NazmulRemon/SAP-1/README.md

# SAP-1
In this project we implemented an 8-bit computer based on the architecture of SAP-1 (Simple-As-Possible) using combinational and sequential circuits.
