NazmulRemon/SAP-1/Instruction Register/bottomcopper_mirrer.PDF

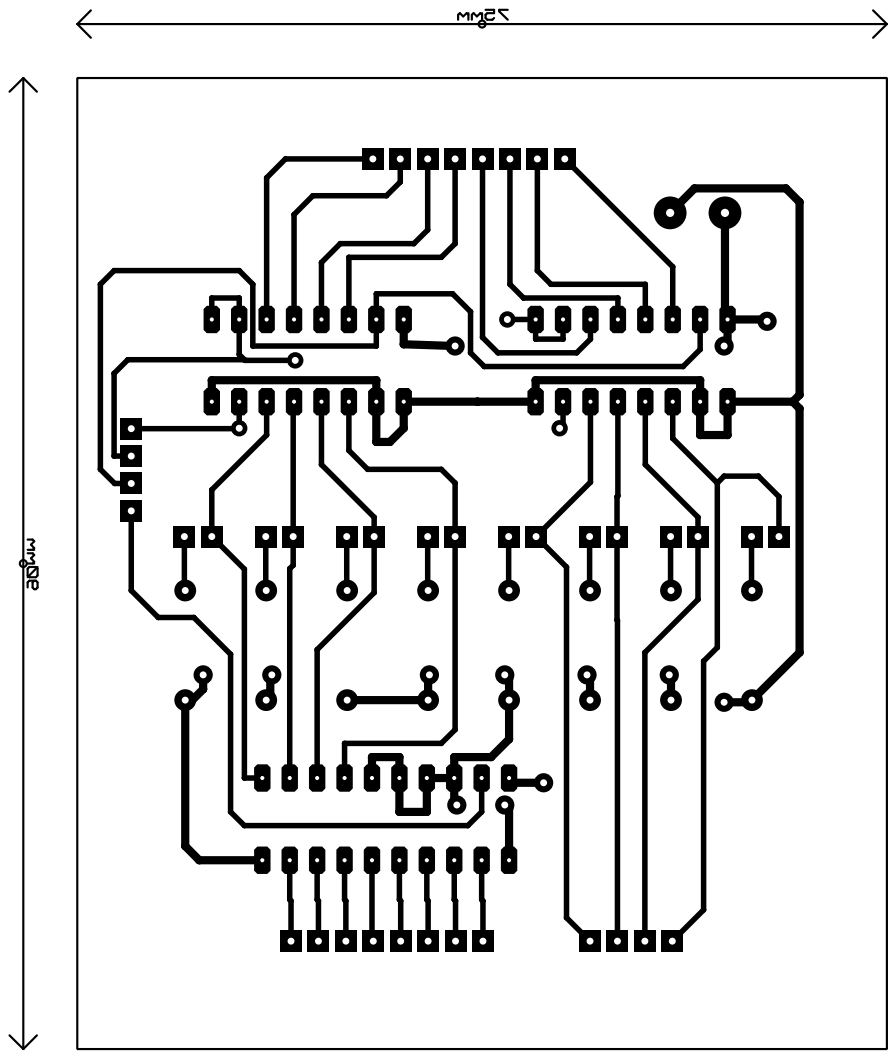
[picture p33: page 1]
