NazmulRemon/SAP-1/Instruction Register/topcopper.PDF

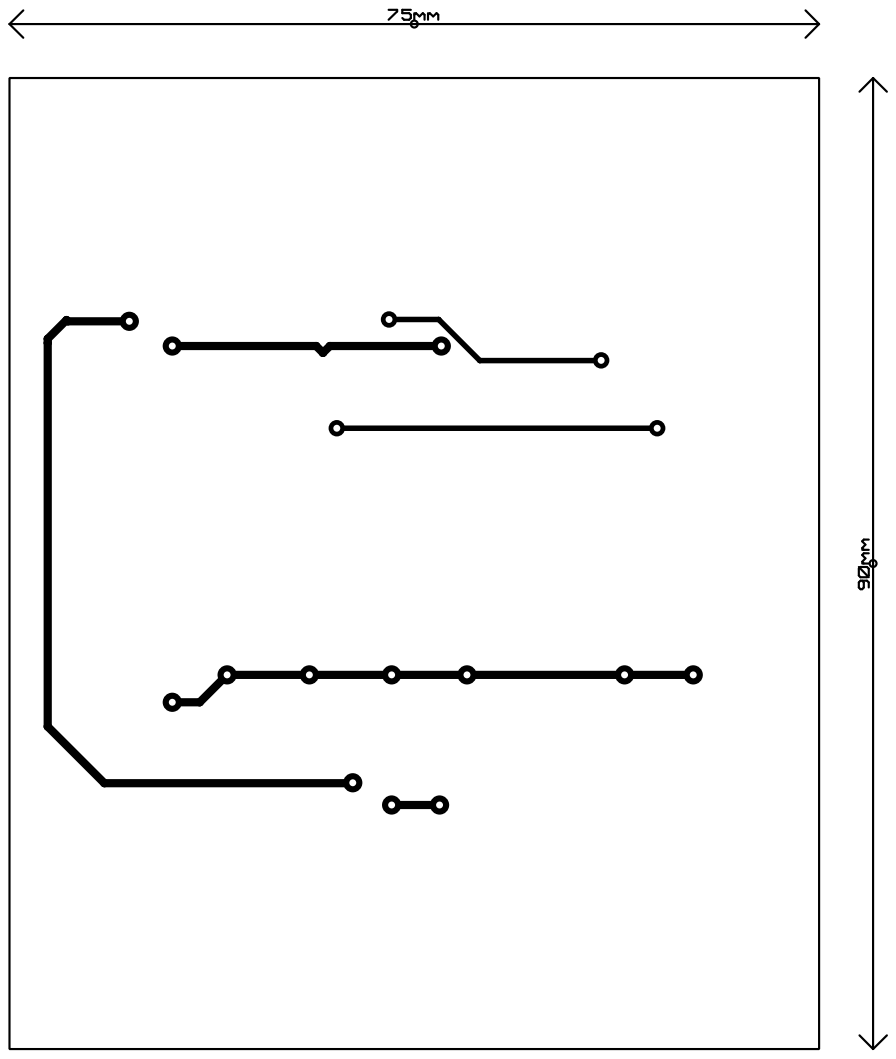
[picture p34: page 1]
