NazmulRemon/SAP-1/Instruction Register/topsilk.PDF

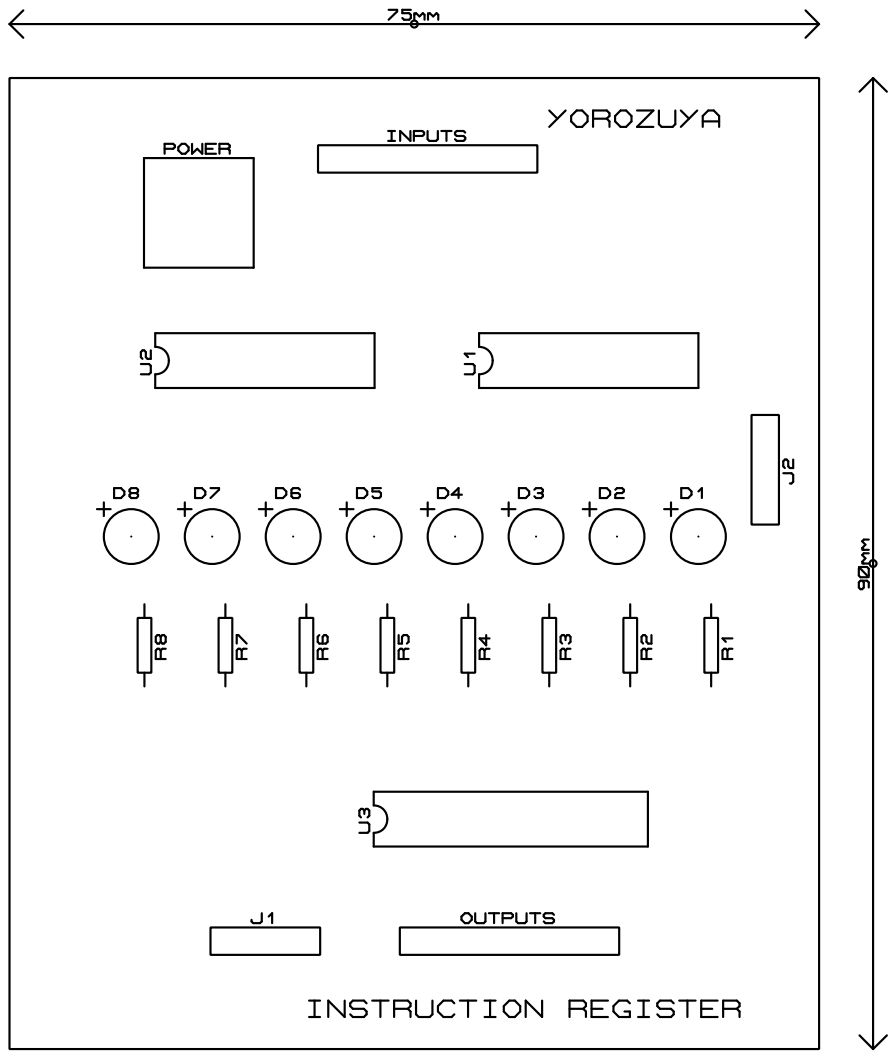
[picture p35: page 1]
