NazmulRemon/SAP-1/RAM/BOTTOMCOPPER_MIRROR.PDF

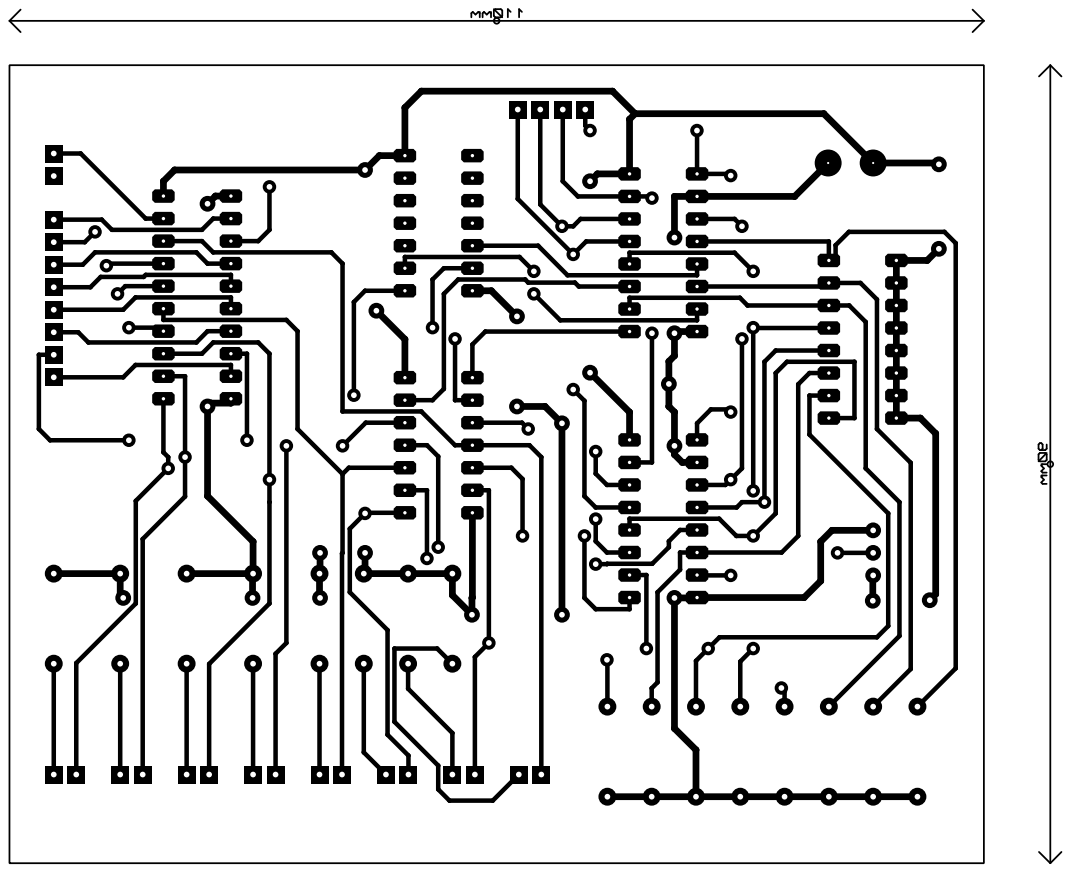
[picture p36: page 1]
