NazmulRemon/SAP-1/RAM/TOPCOPPER.PDF

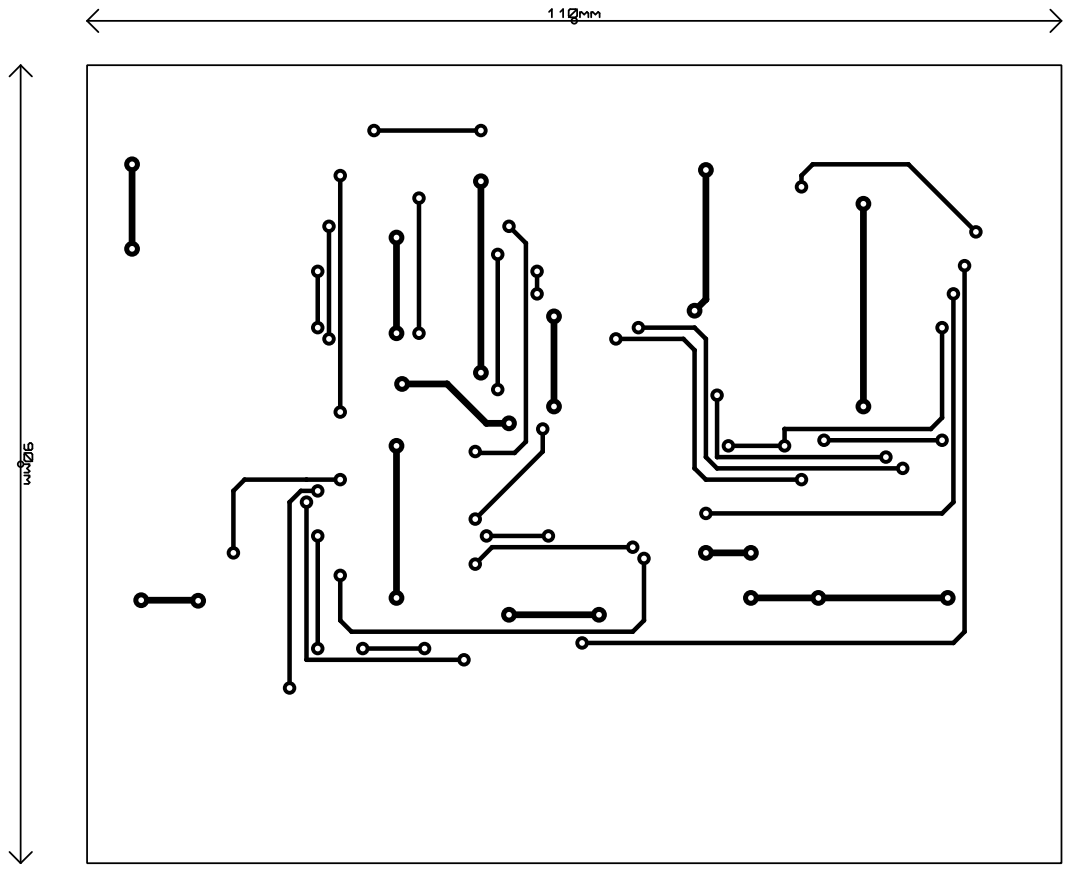
[picture p37: page 1]
