NazmulRemon/SAP-1/RAM/TOPSILK.PDF

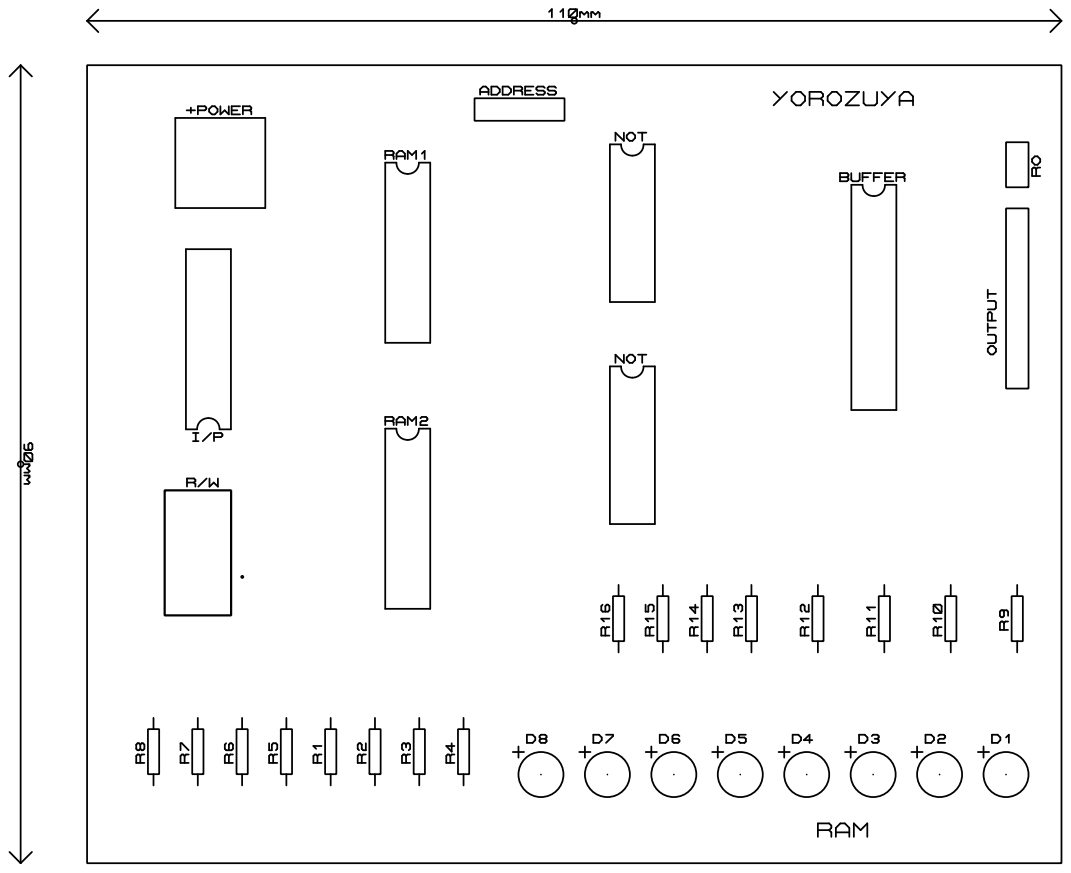
[picture p38: page 1]
