NazmulRemon/SAP-1/Power module/BOTTOMCOPPER.PDF

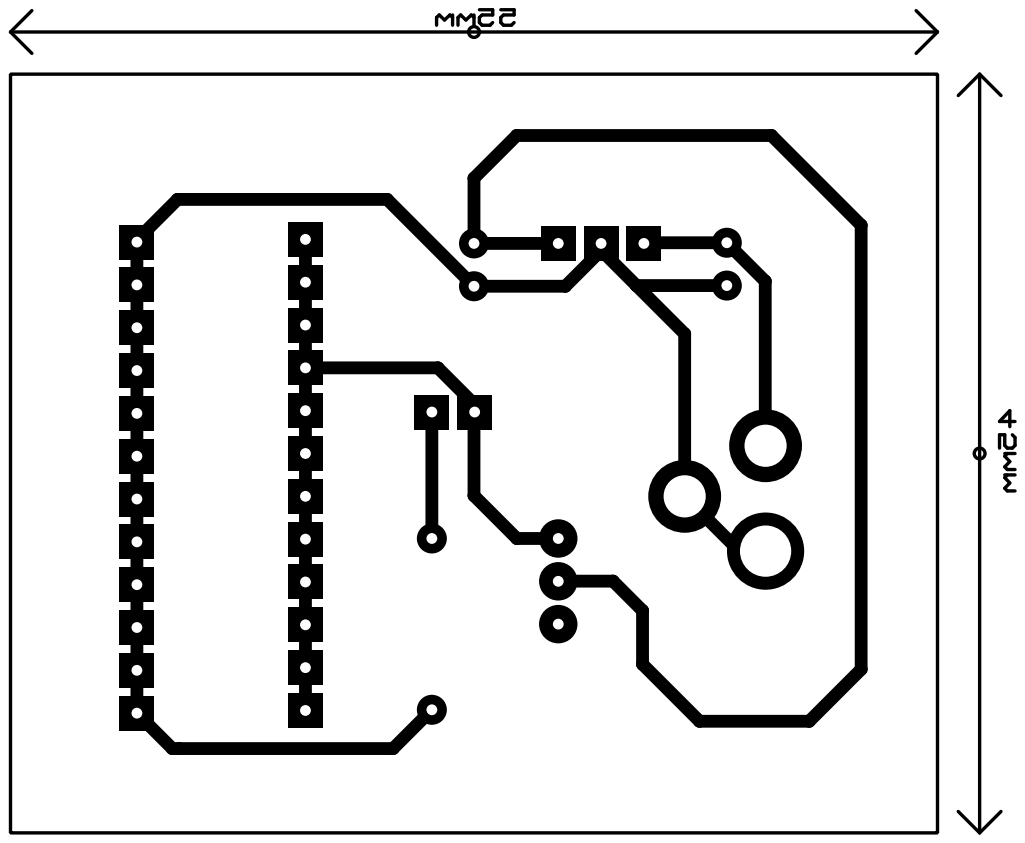
[picture p39: page 1]
