NazmulRemon/SAP-1/Power module/TOPSILK.PDF

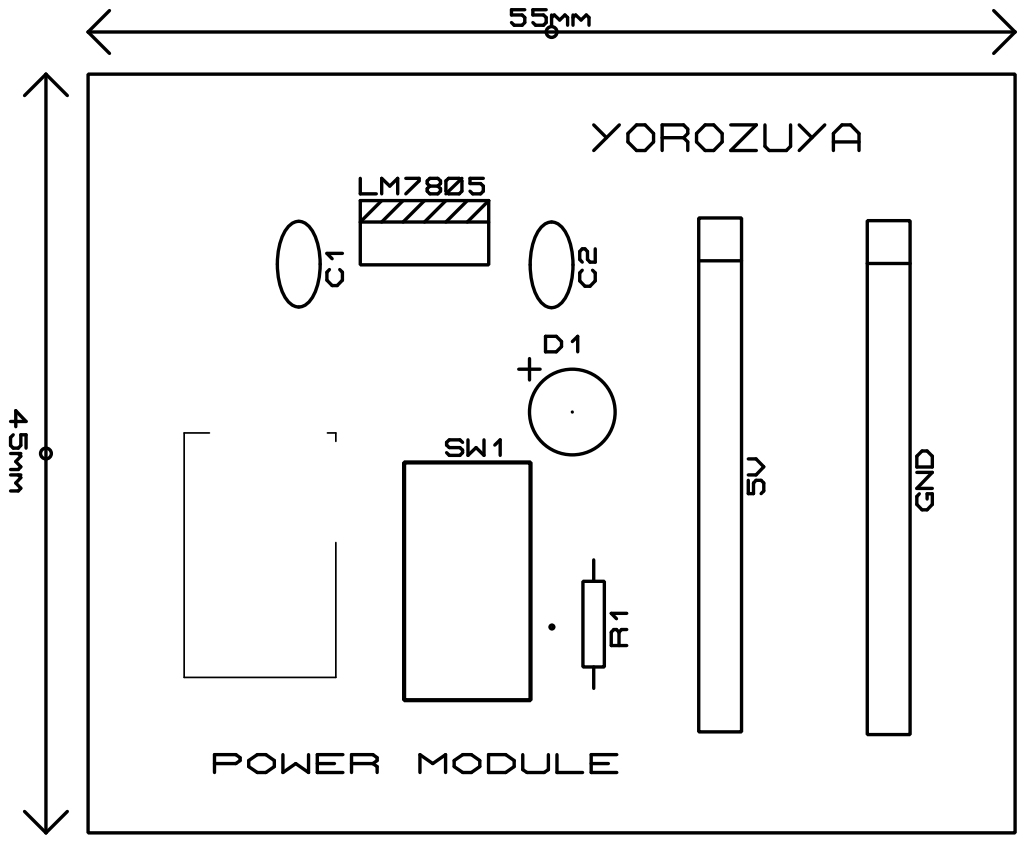
[picture p40: page 1]
