NazmulRemon/SAP-1/Control Sequencer/Bottom copper_Mirror.PDF

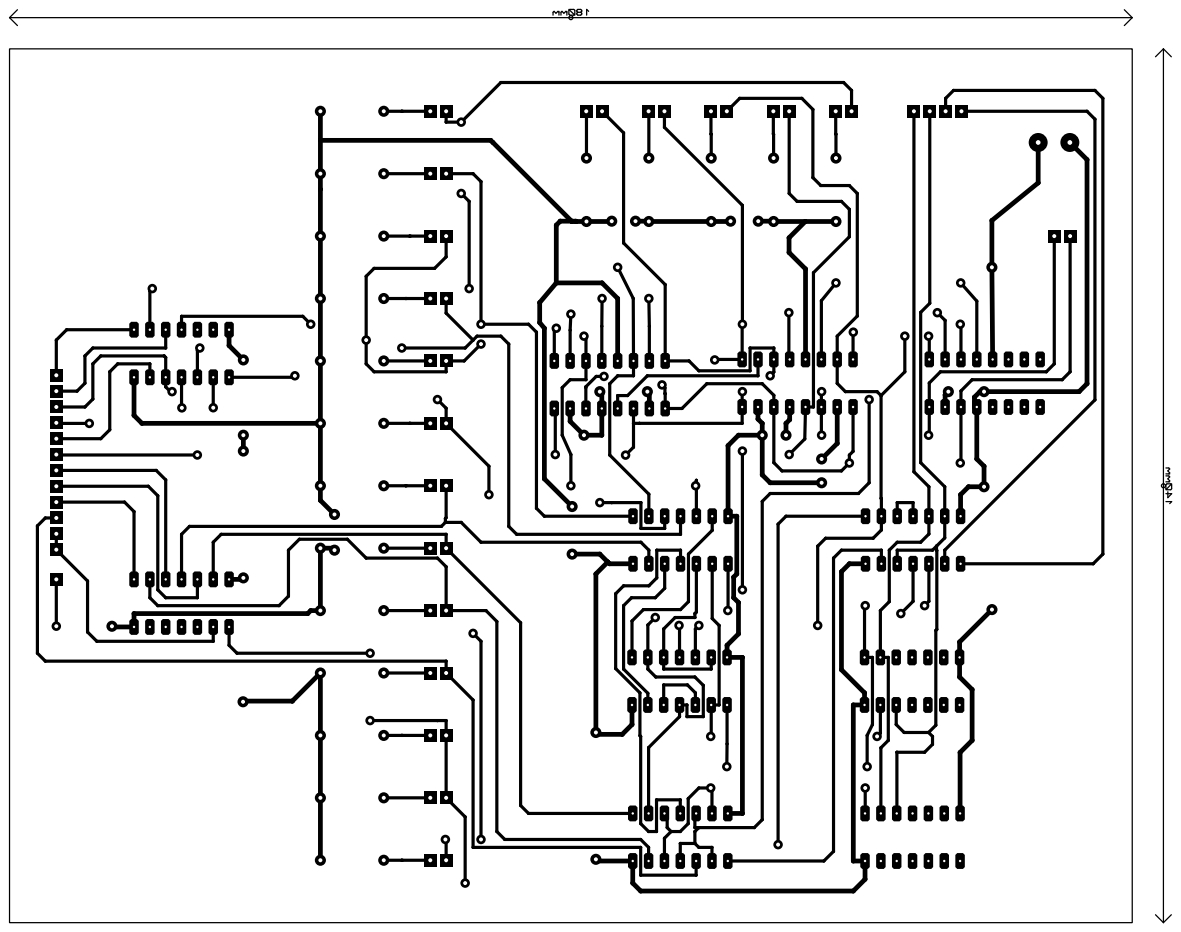
[picture p41: page 1]
