NazmulRemon/SAP-1/Control Sequencer/Top copper.PDF

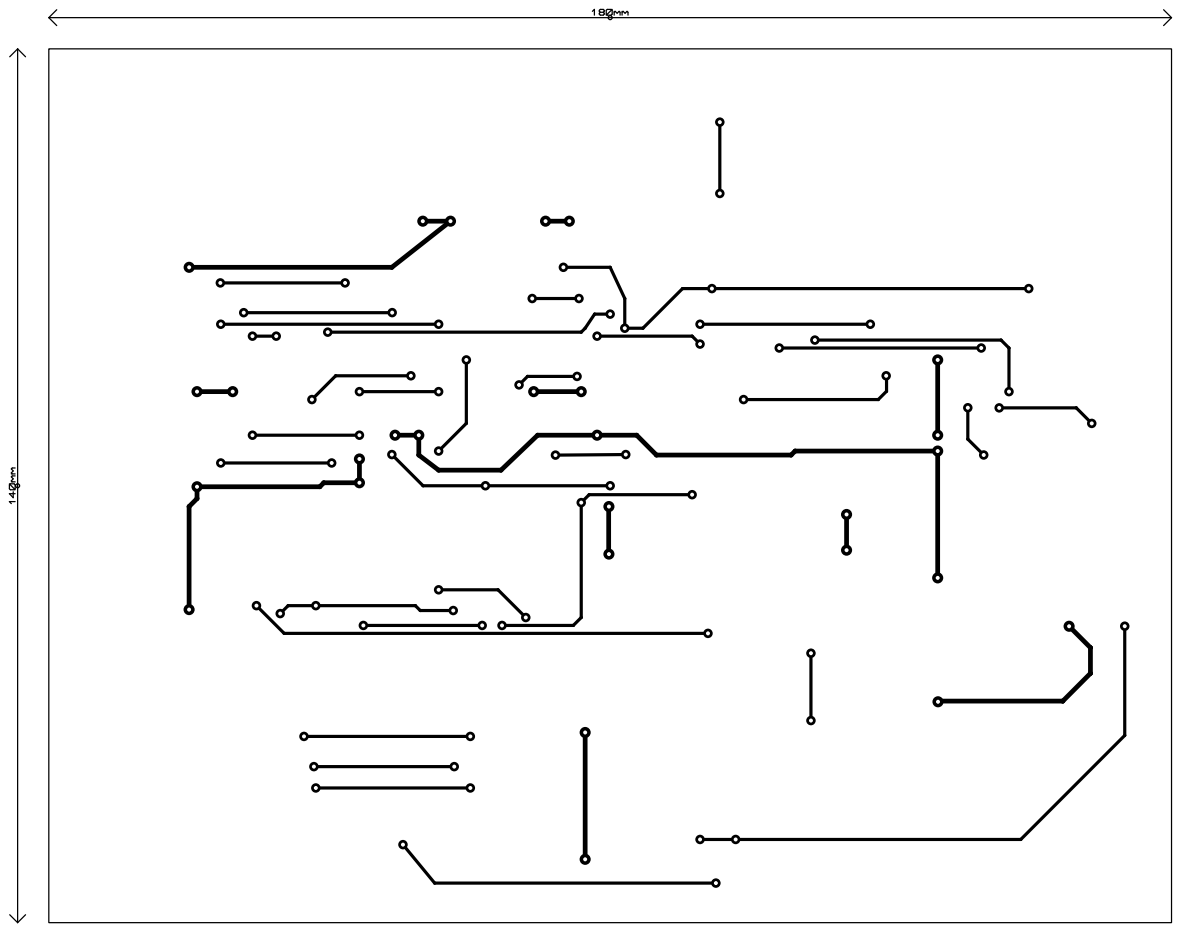
[picture p42: page 1]
