NazmulRemon/SAP-1/Control Sequencer/Top silk.PDF

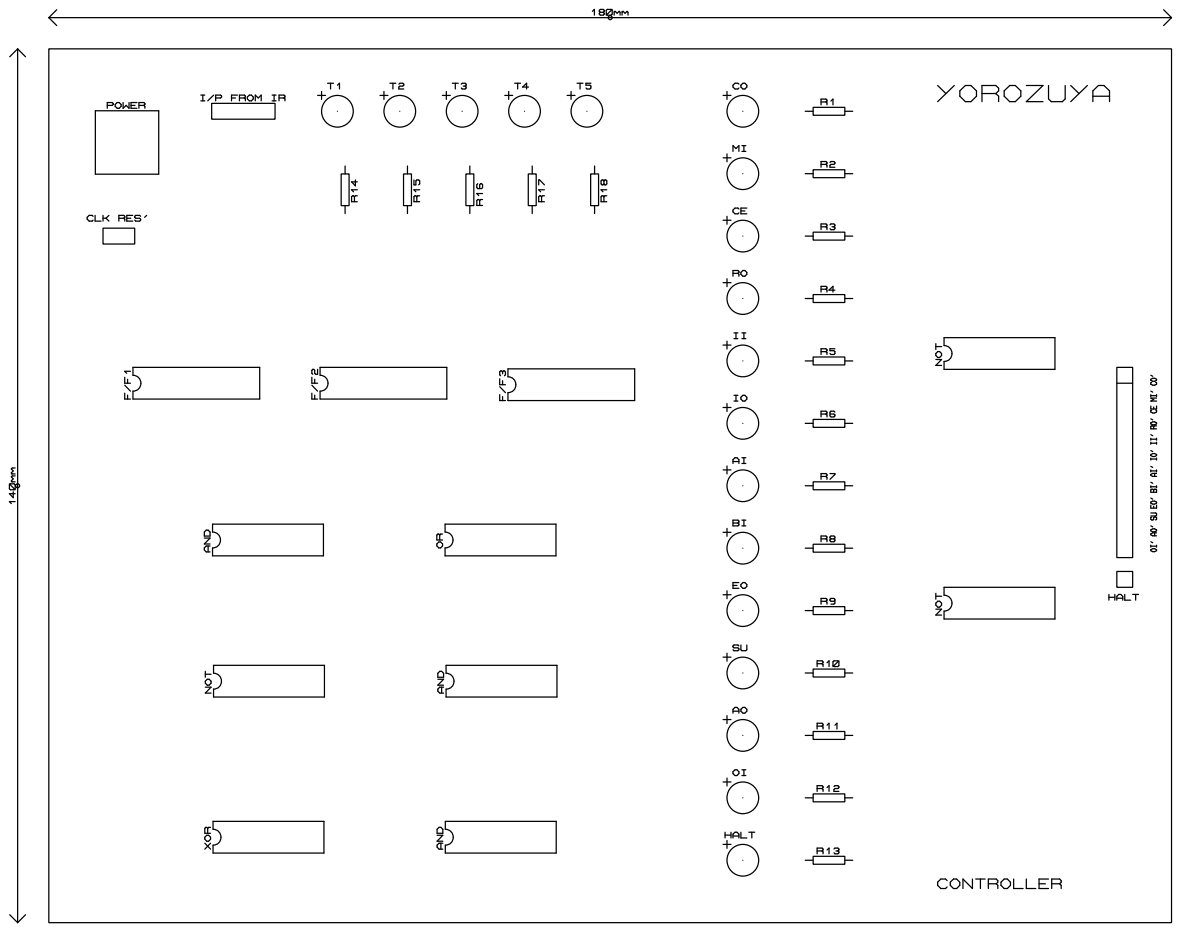
[picture p43: page 1]
