NazmulRemon/SAP-1/Clock/Bottomcopper_mirror.PDF

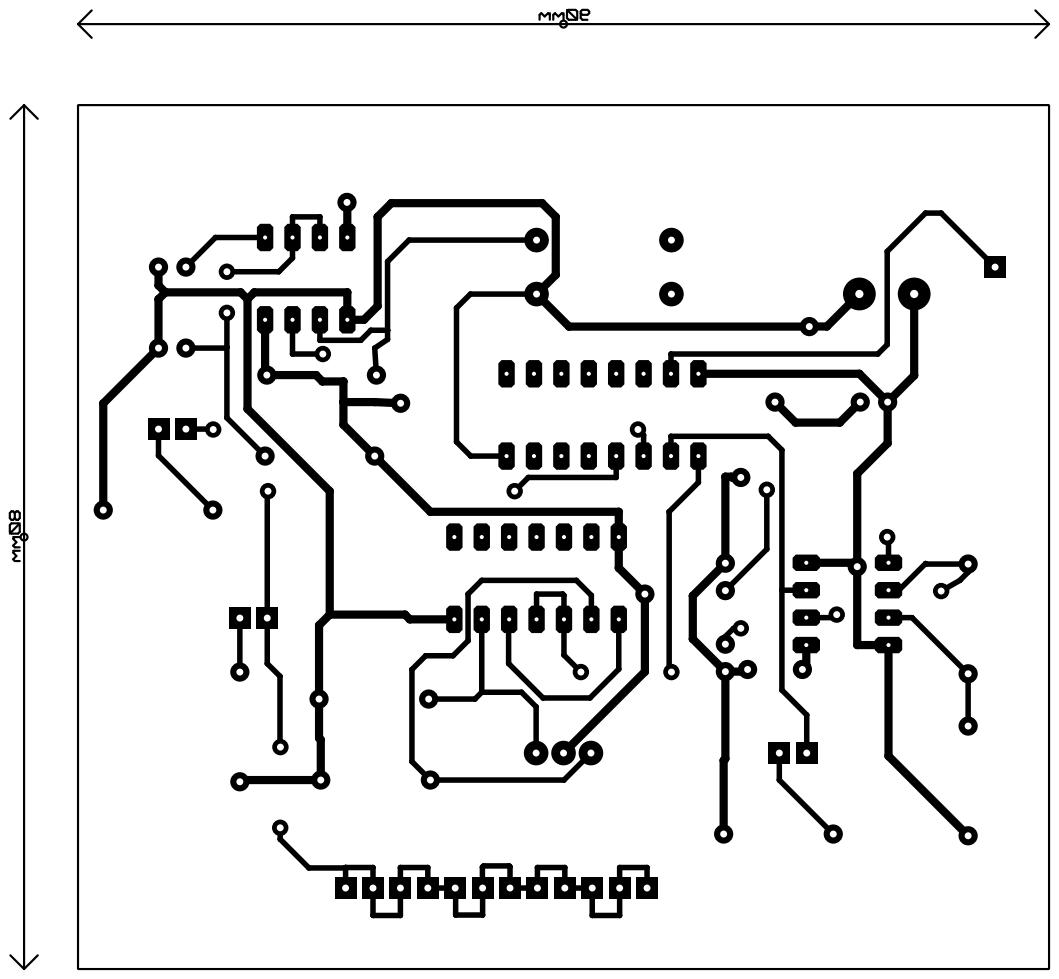
[picture p44: page 1]
