NazmulRemon/SAP-1/Clock/clock.PDF

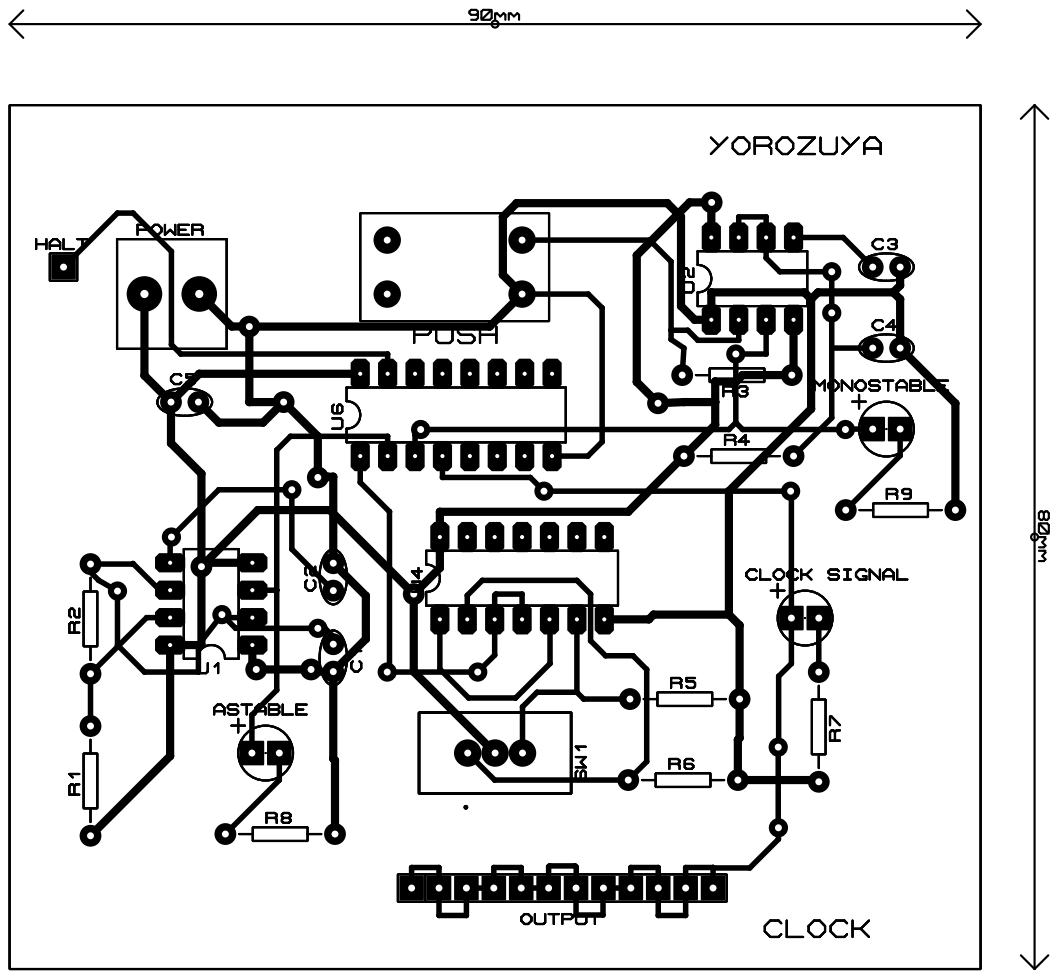
[picture p45: page 1]
