NazmulRemon/SAP-1/Clock/drill.PDF

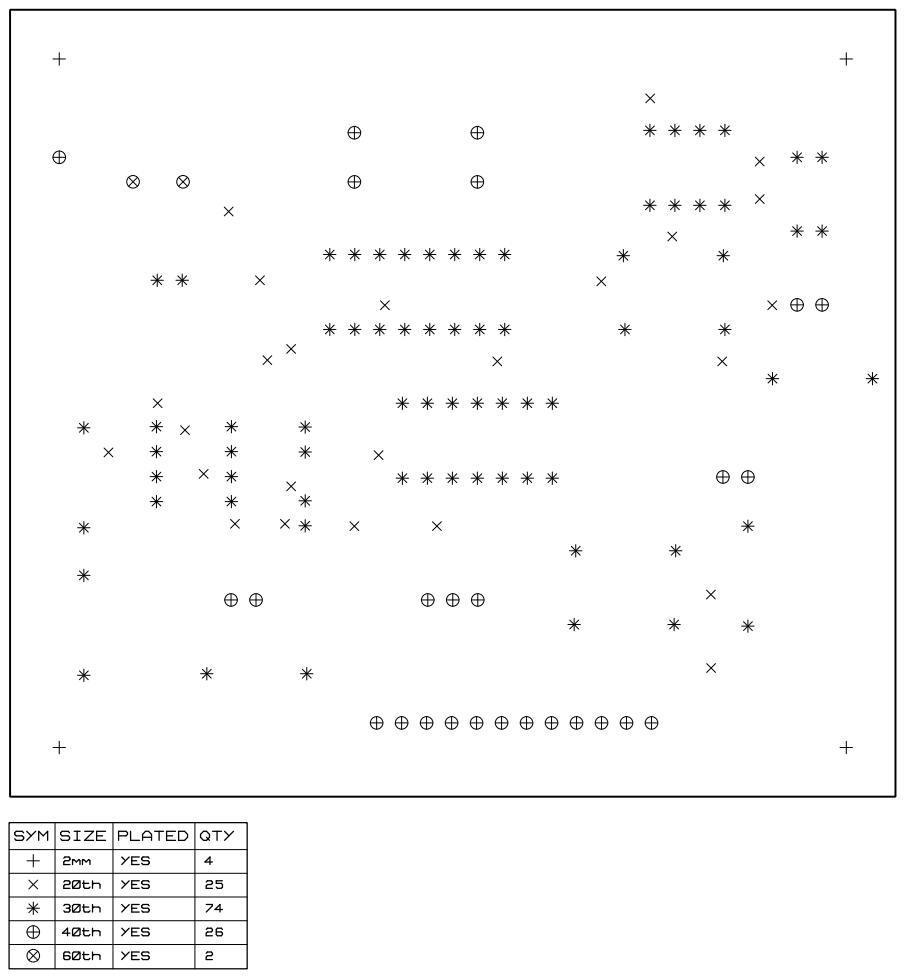
[picture p46: page 1]
