NazmulRemon/SAP-1/Clock/pcb_clock.PDF

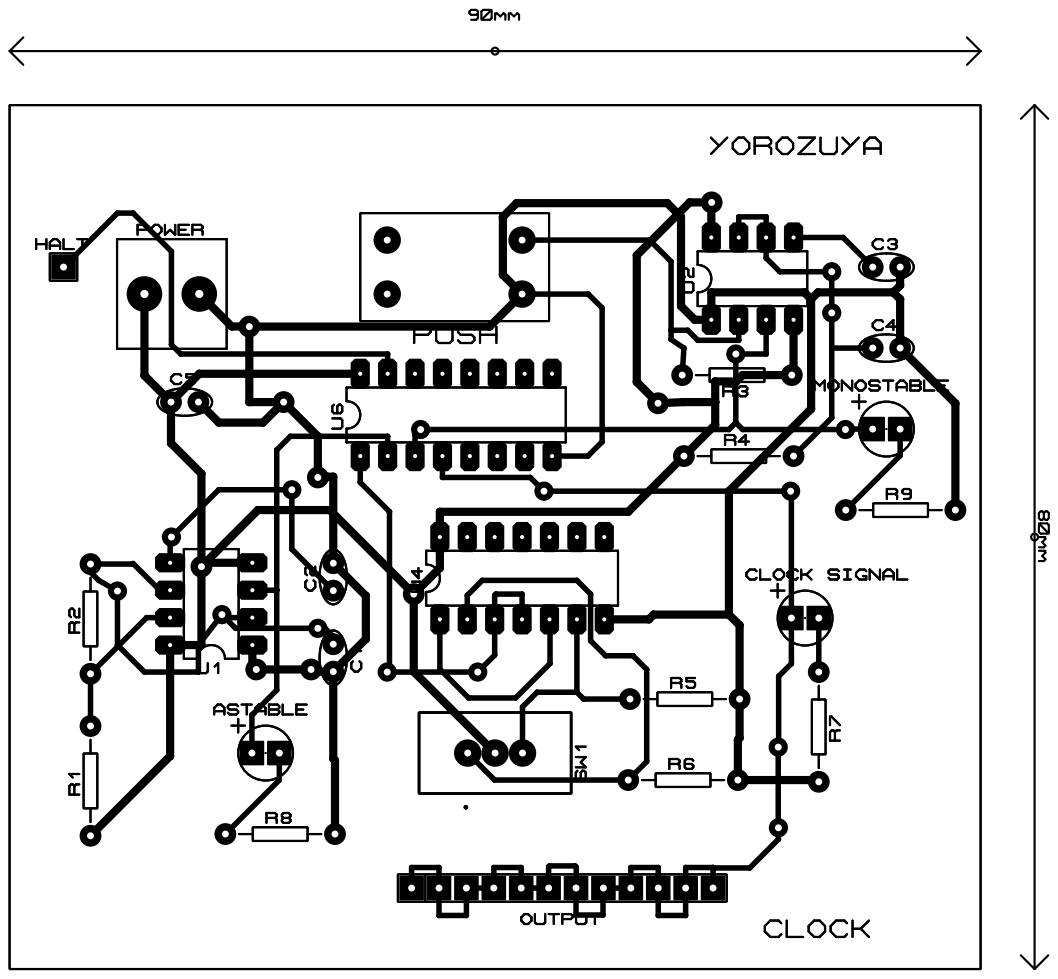
[picture p47: page 1]
