NazmulRemon/SAP-1/Clock/topcopper.PDF

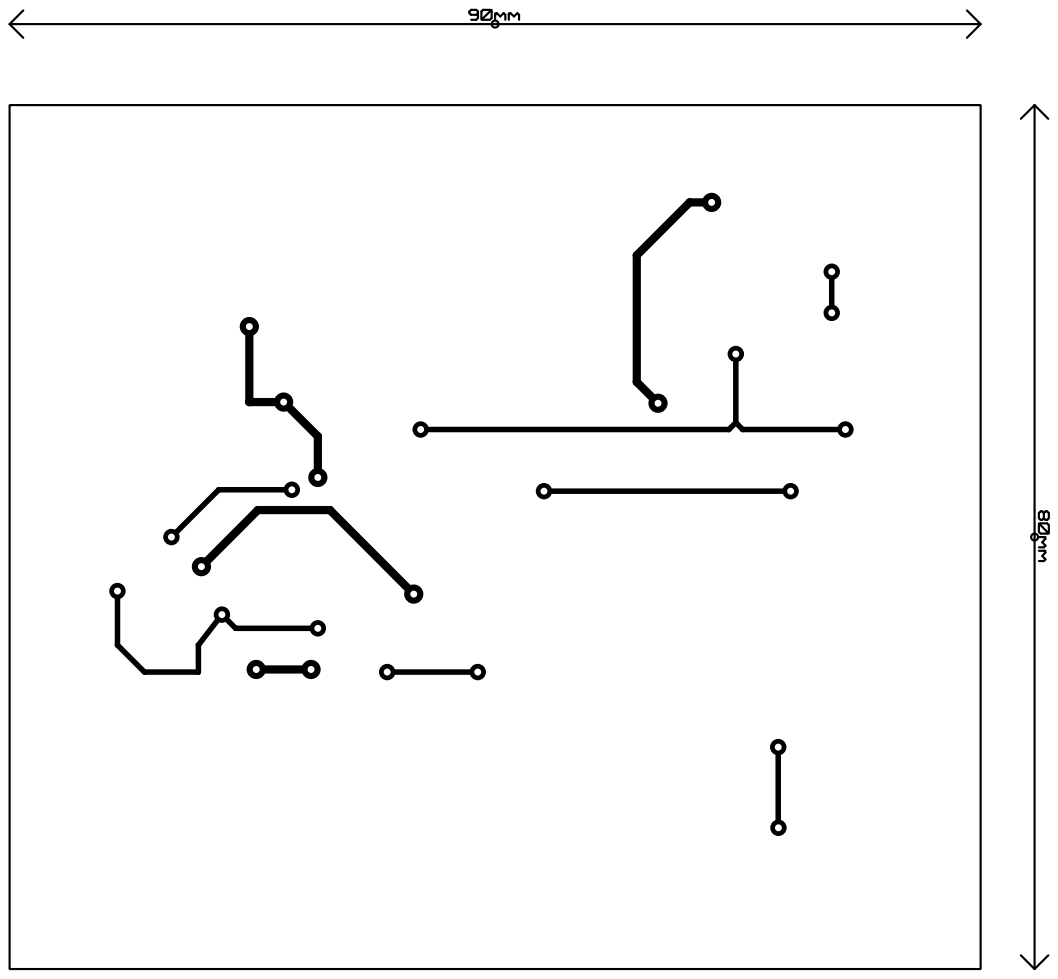
[picture p48: page 1]
