NazmulRemon/SAP-1/Clock/topsilk.PDF

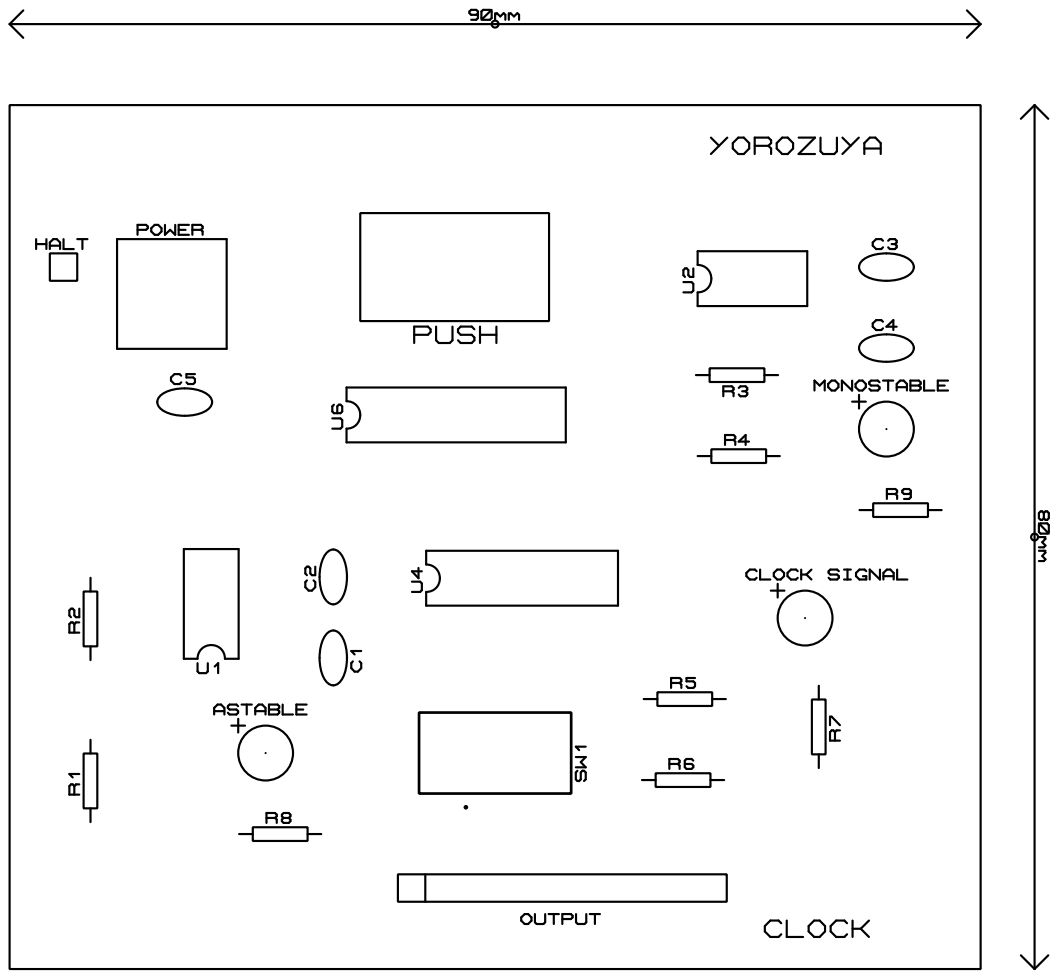
[picture p49: page 1]
