NazmulRemon/SAP-1/BUS/BOTTOMCOPPER_MIRRORED.PDF

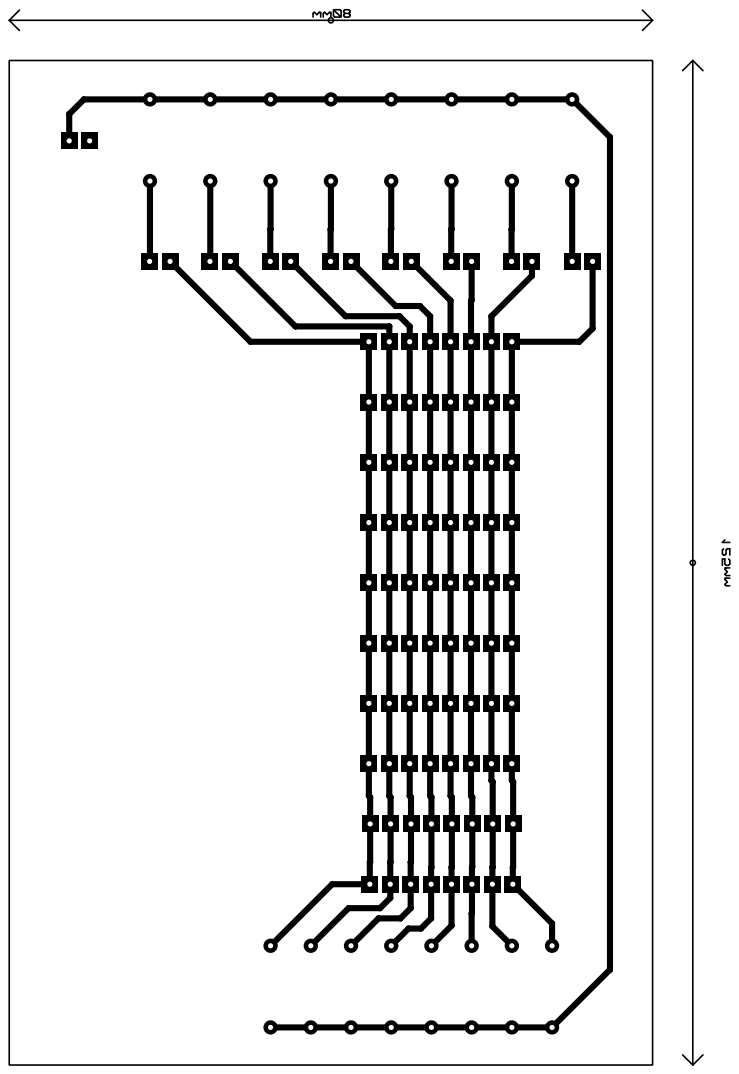
[picture p50: page 1]
