NazmulRemon/SAP-1/BUS/TOPSILK.PDF

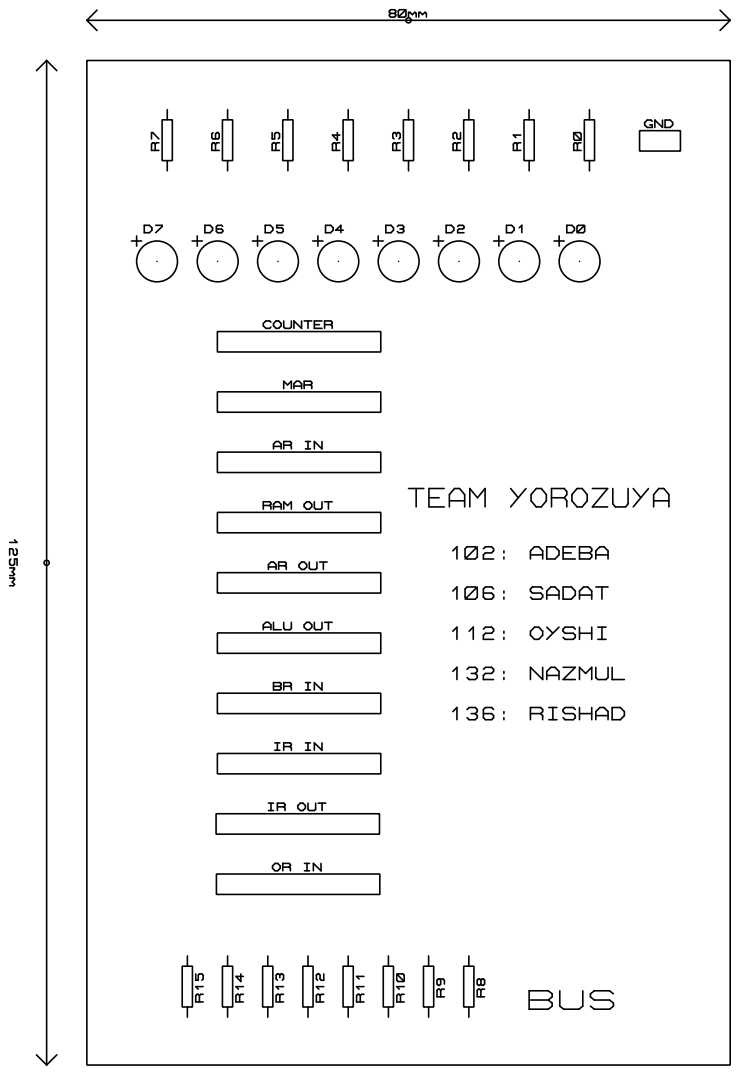
[picture p51: page 1]
