NazmulRemon/SAP-1/B register/botomcopper_mirror.PDF

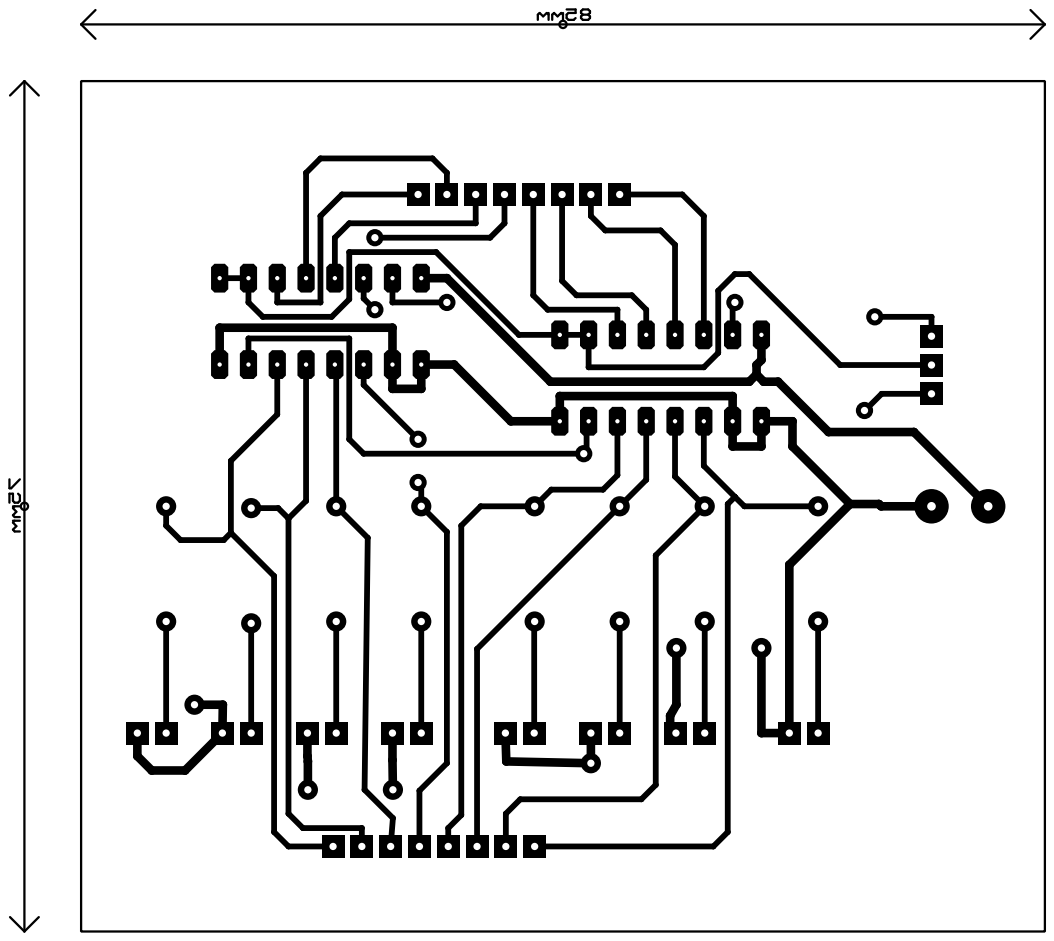
[picture p52: page 1]
