NazmulRemon/SAP-1/B register/topcopper.PDF

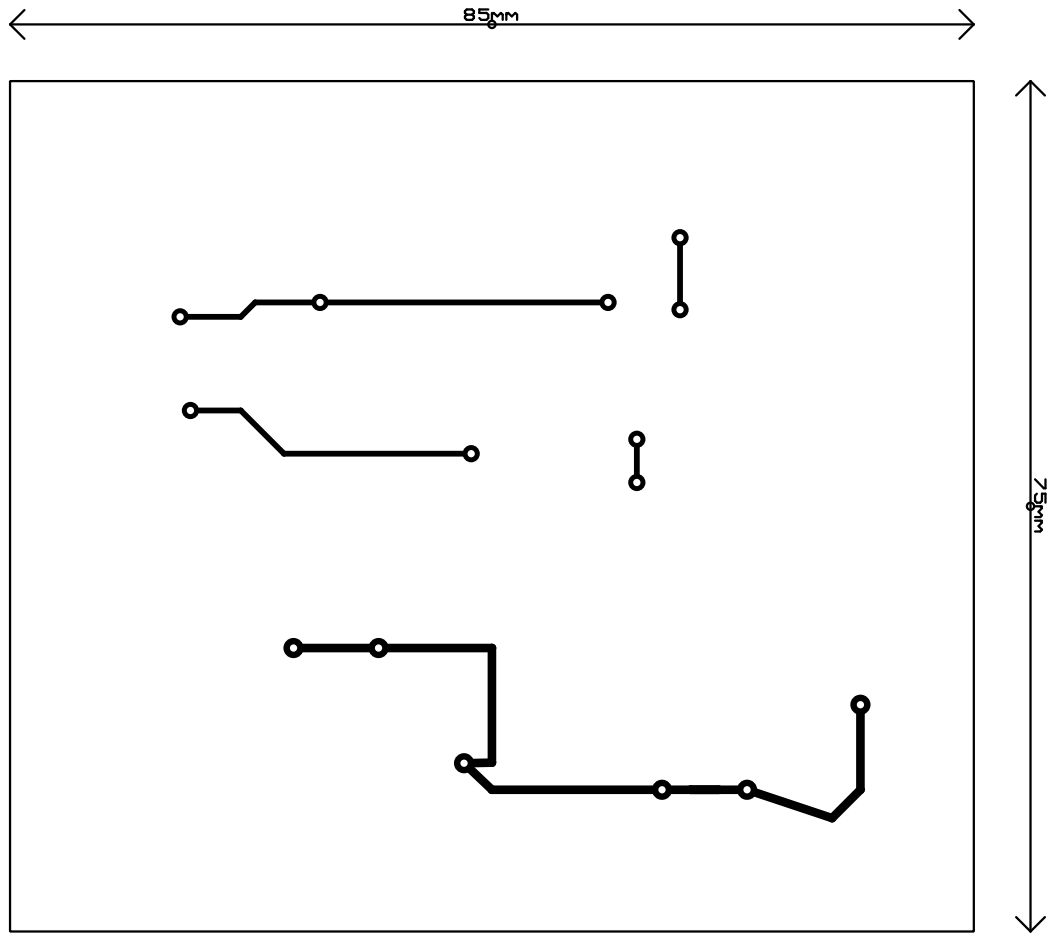
[picture p53: page 1]
