NazmulRemon/SAP-1/B register/topsilk.PDF

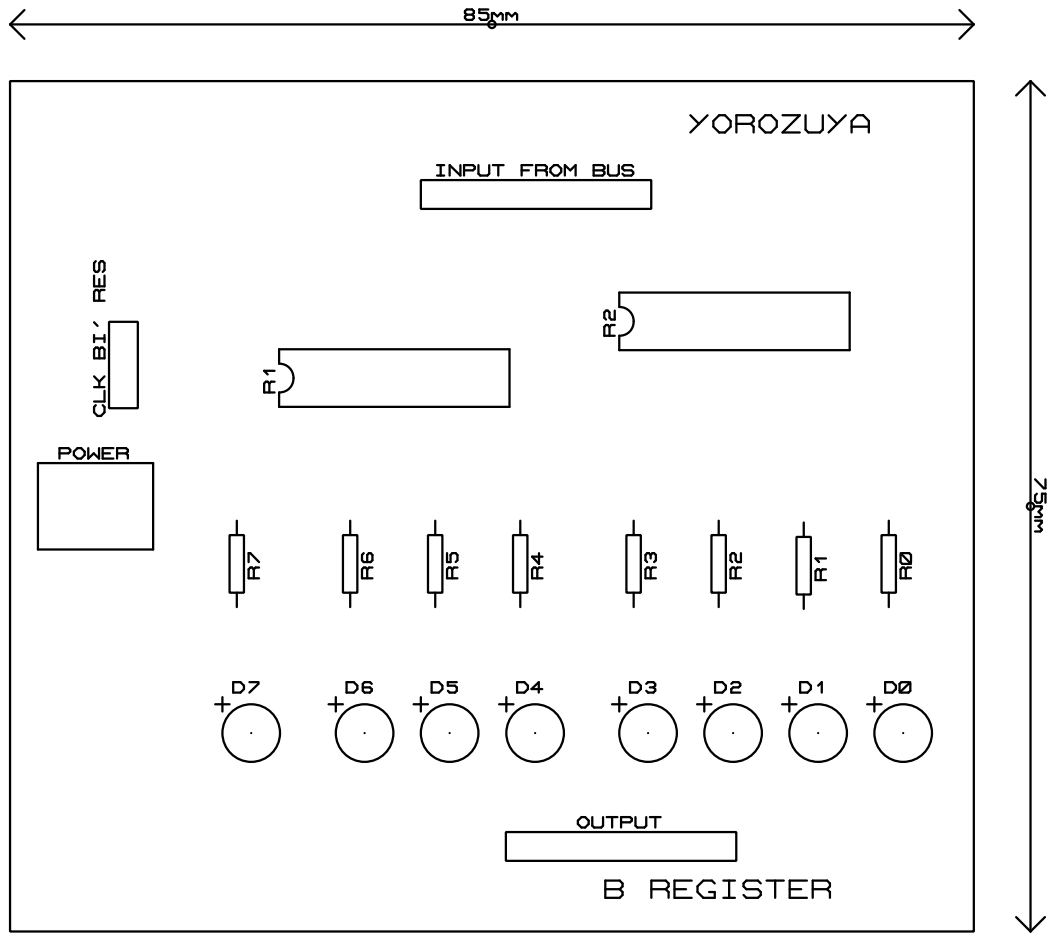
[picture p54: page 1]
