NazmulRemon/SAP-1/Accumulator/BOTTOMCOPPER_MIRRORED.PDF

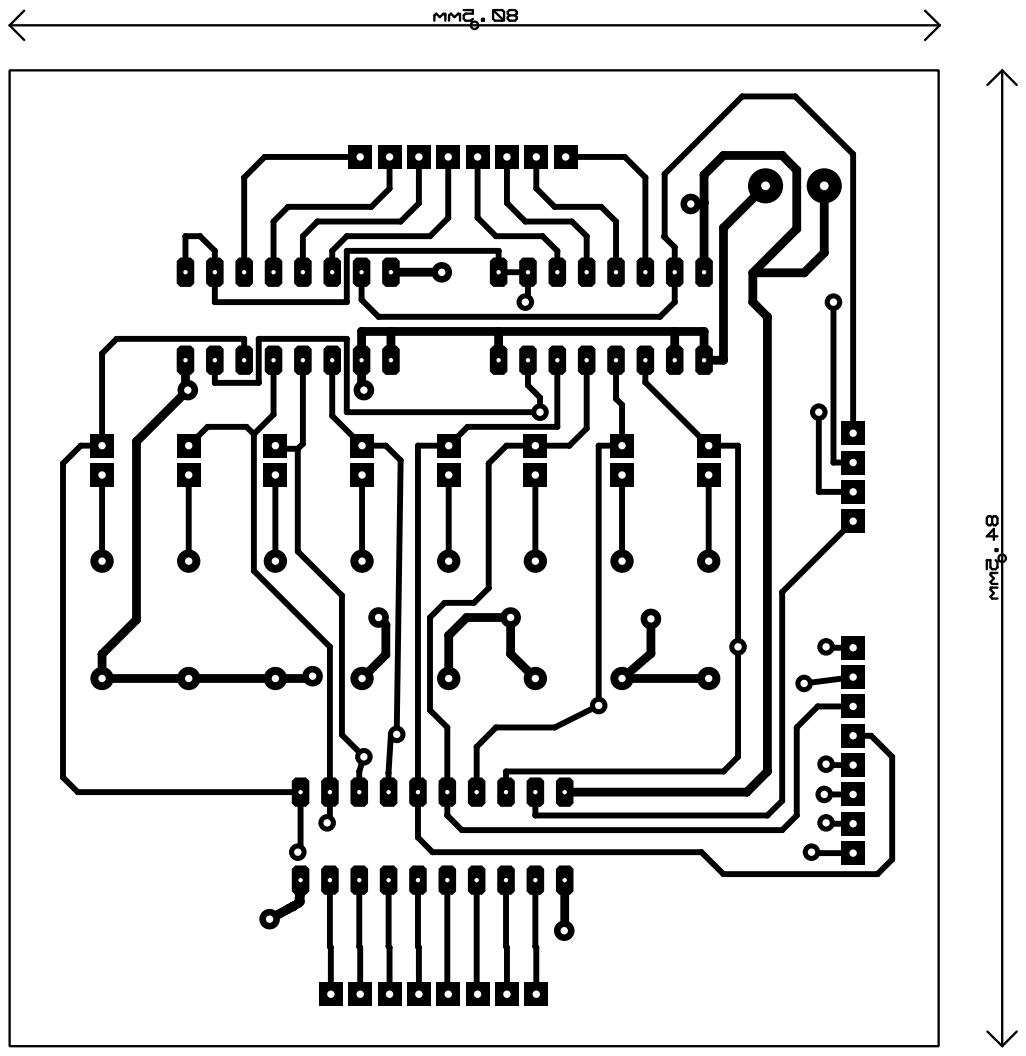
[picture p55: page 1]
