NazmulRemon/SAP-1/Accumulator/TOPCOPPER.PDF

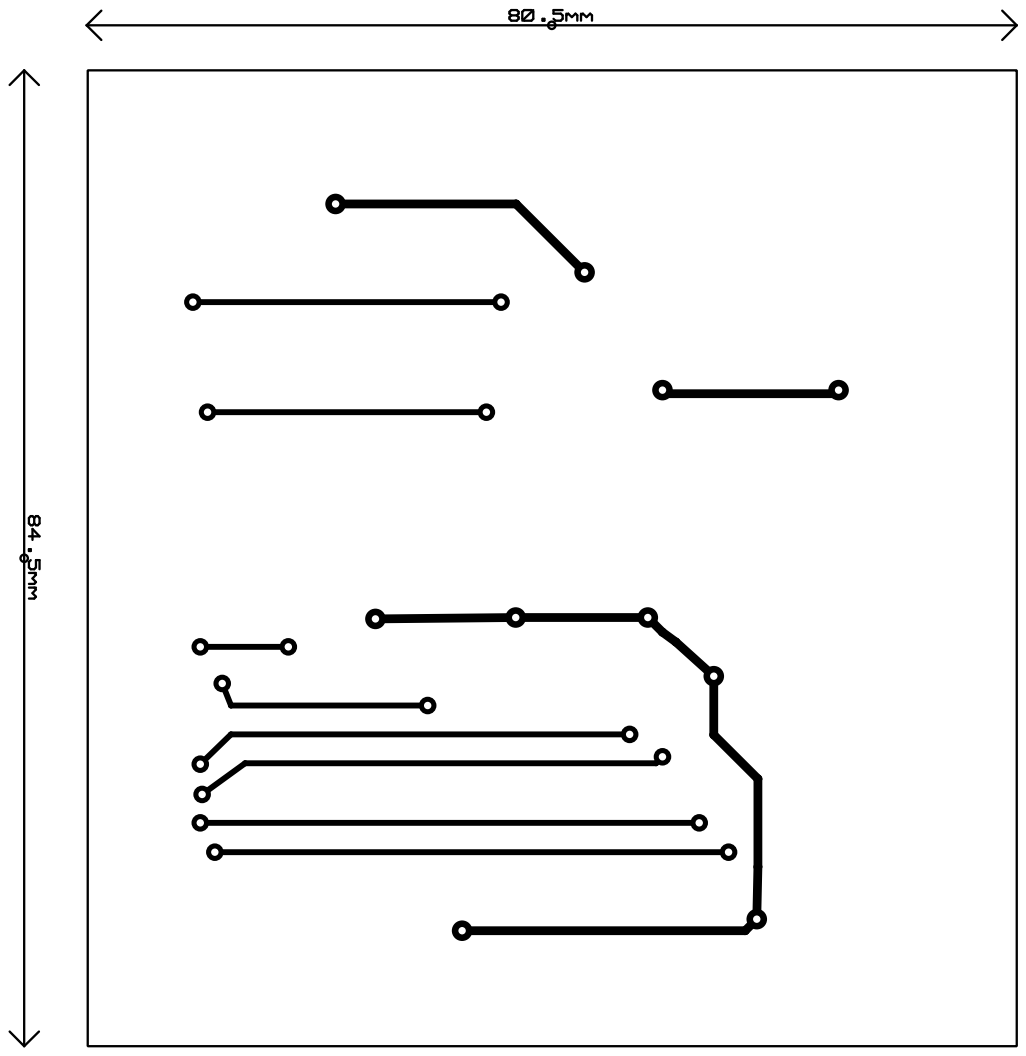
[picture p56: page 1]
