NazmulRemon/SAP-1/Accumulator/TOPSILK.PDF

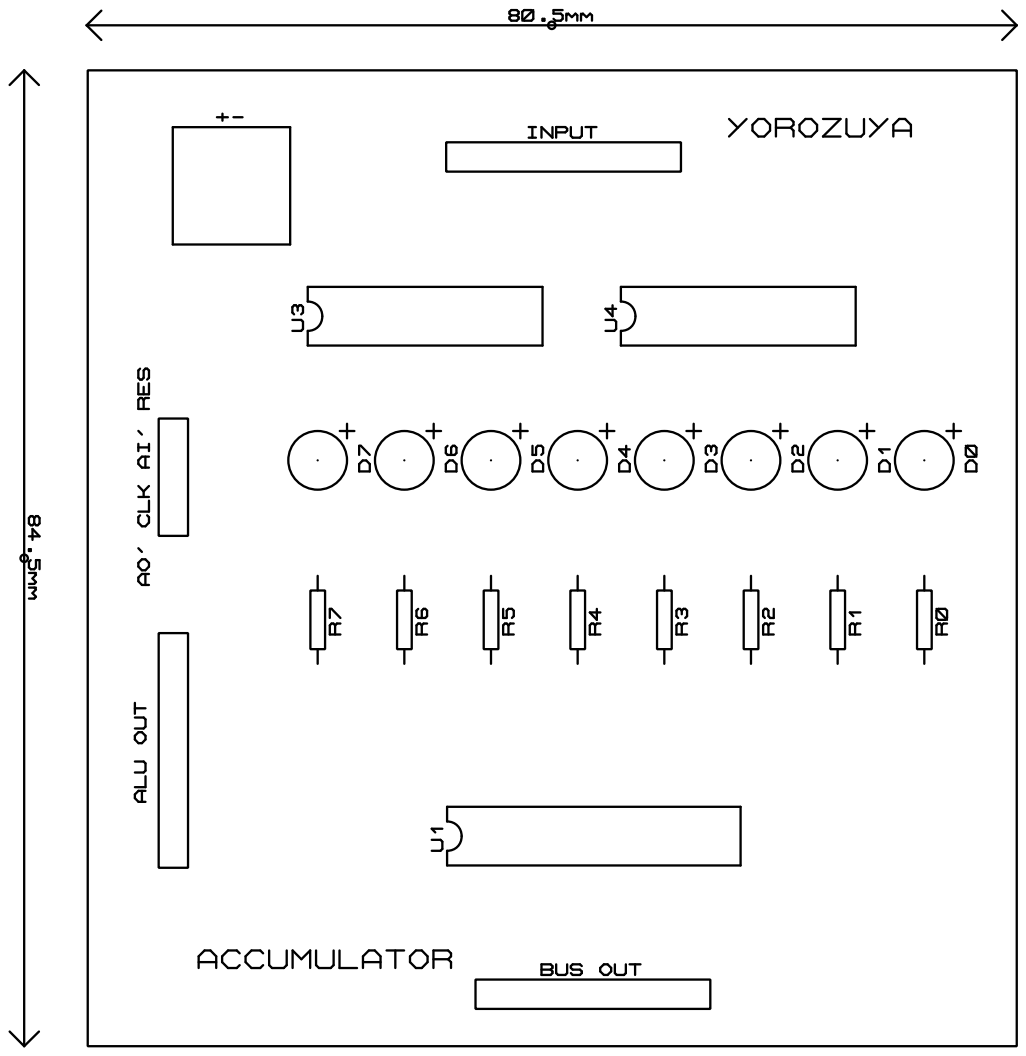
[picture p57: page 1]
