NazmulRemon/SAP-1/Output Register/bottomcopper_mirror.PDF

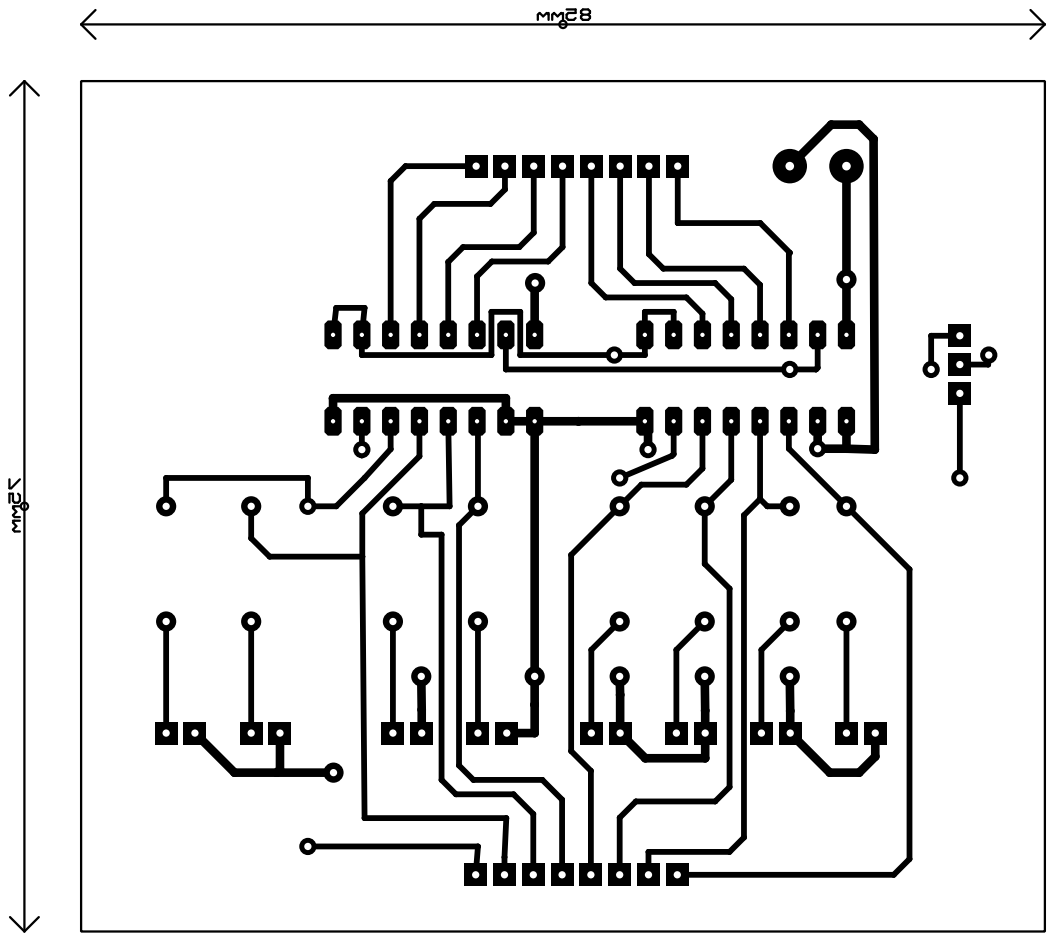
[picture p58: page 1]
