NazmulRemon/SAP-1/Output Register/topcopper.PDF

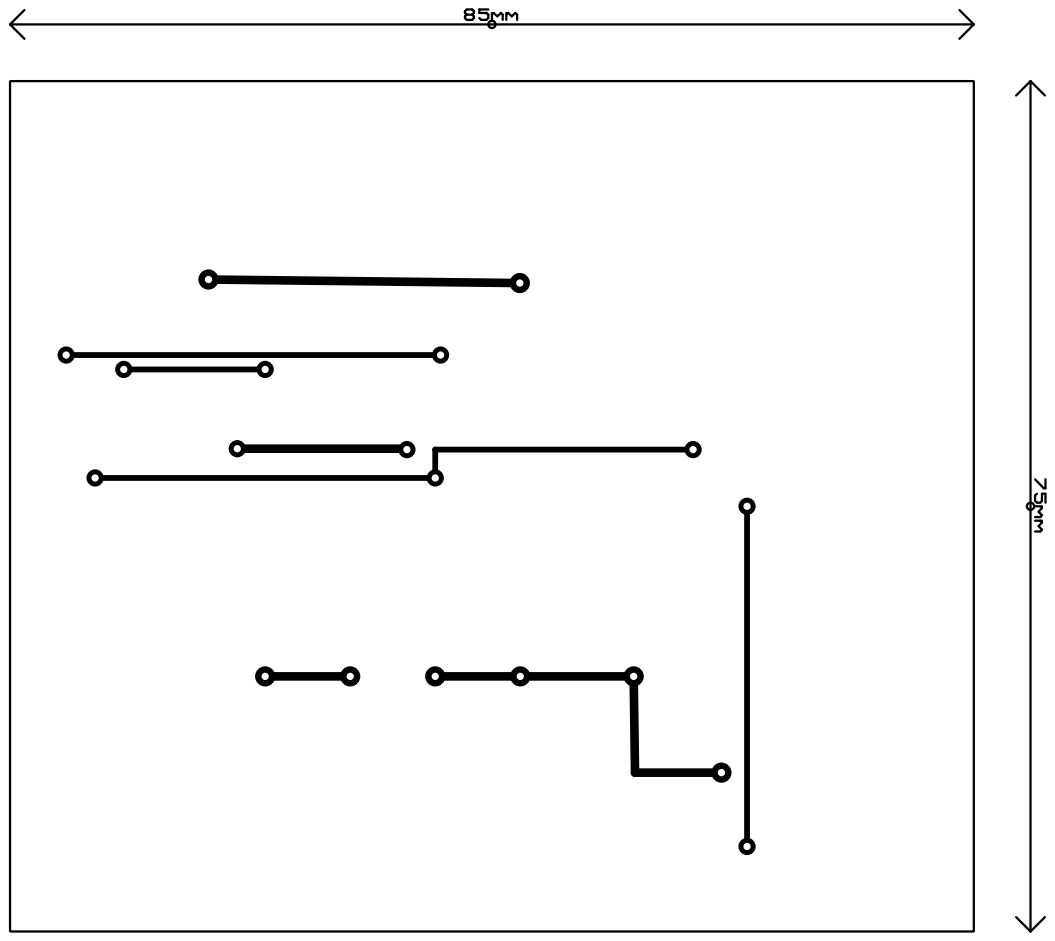
[picture p59: page 1]
