NazmulRemon/SAP-1/Output Register/topsilk.PDF

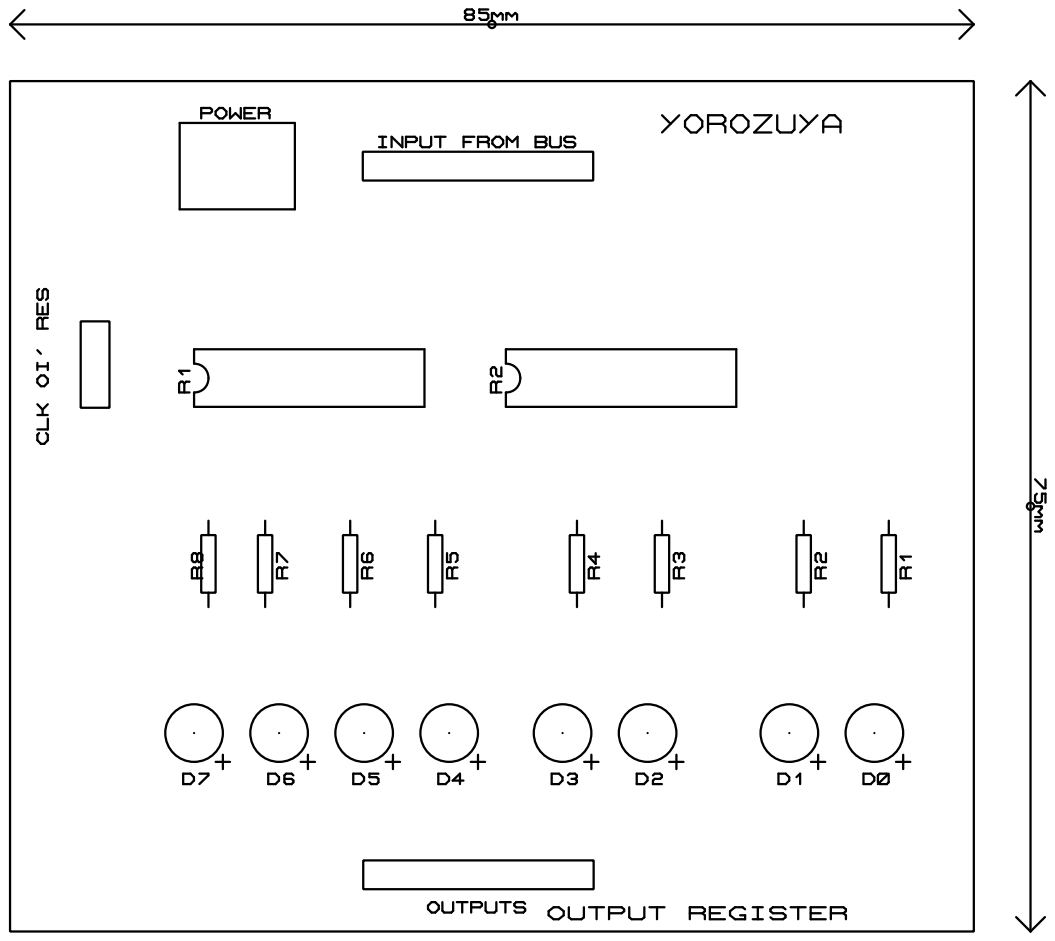
[picture p60: page 1]
