NazmulRemon/SAP-1/IP and MAR/BOTTOMCOPPER_MIRROR.PDF

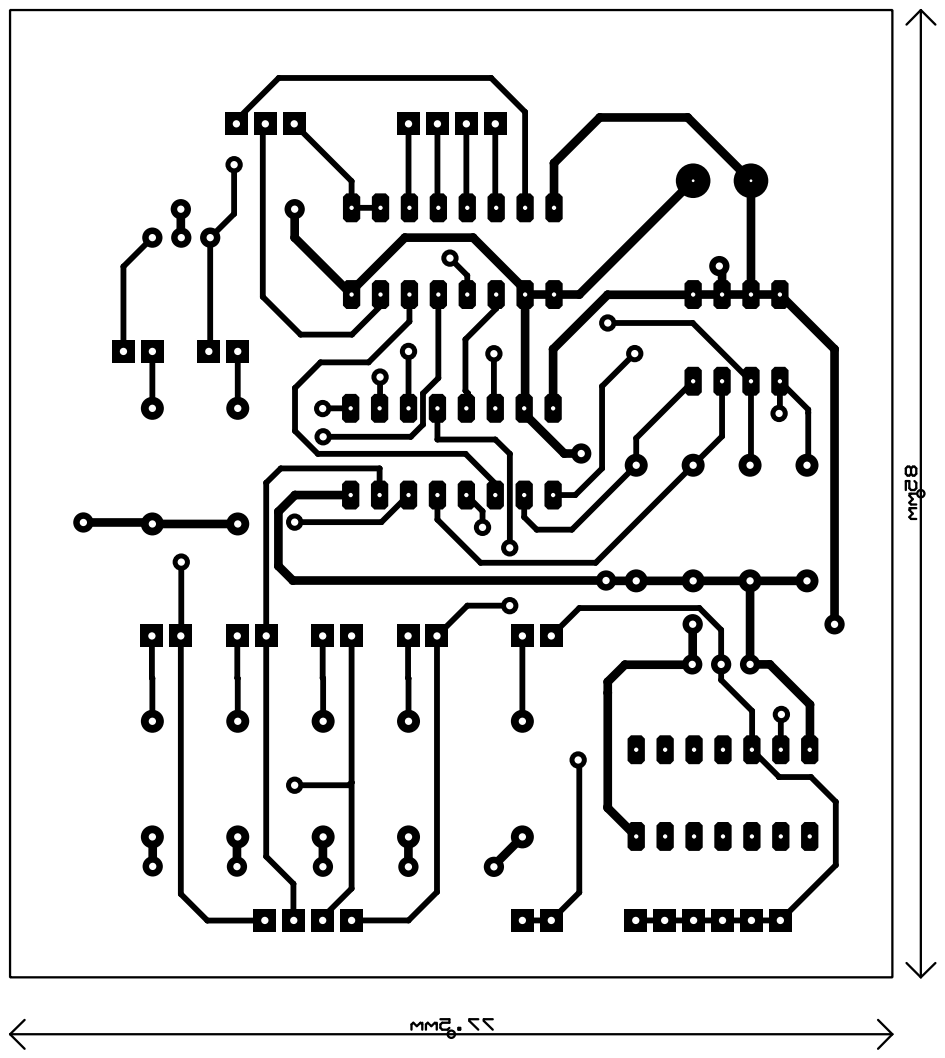
[picture p61: page 1]
