NazmulRemon/SAP-1/IP and MAR/TOPCOPPER.PDF

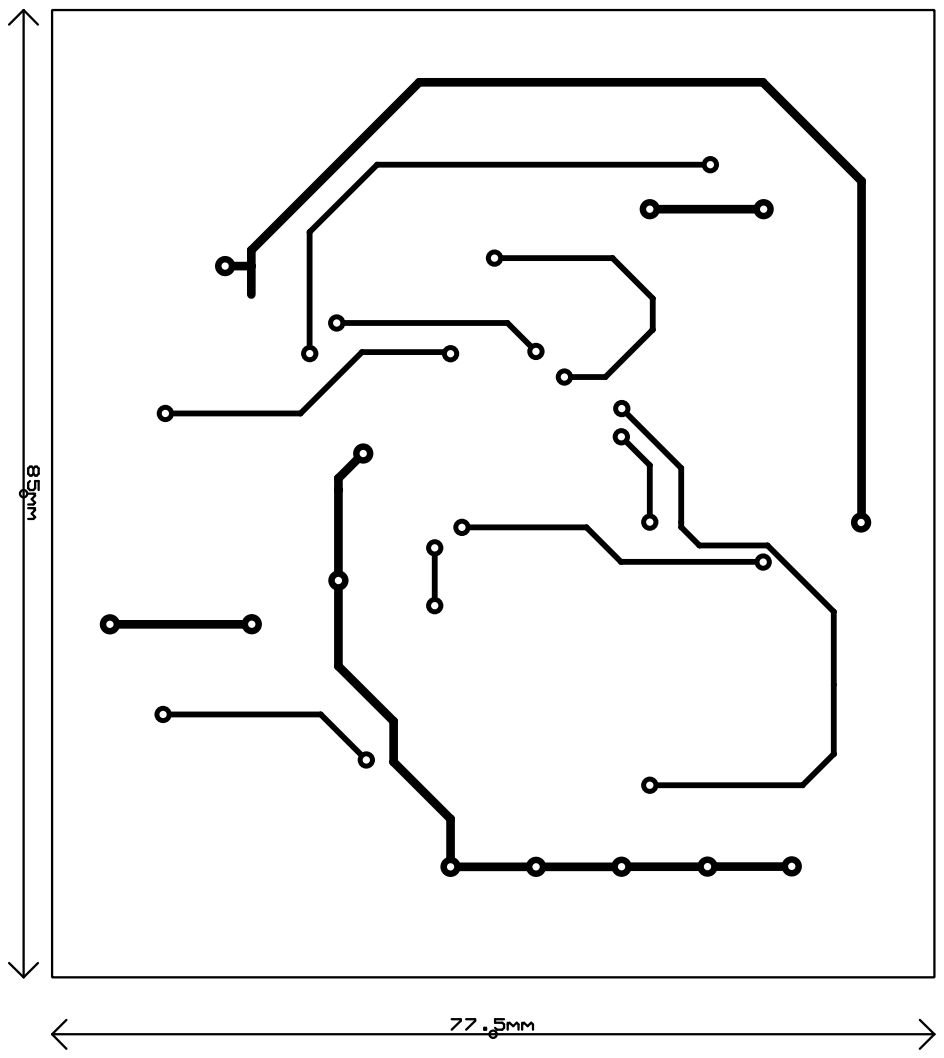
[picture p62: page 1]
