NazmulRemon/SAP-1/IP and MAR/TOPSILK.PDF

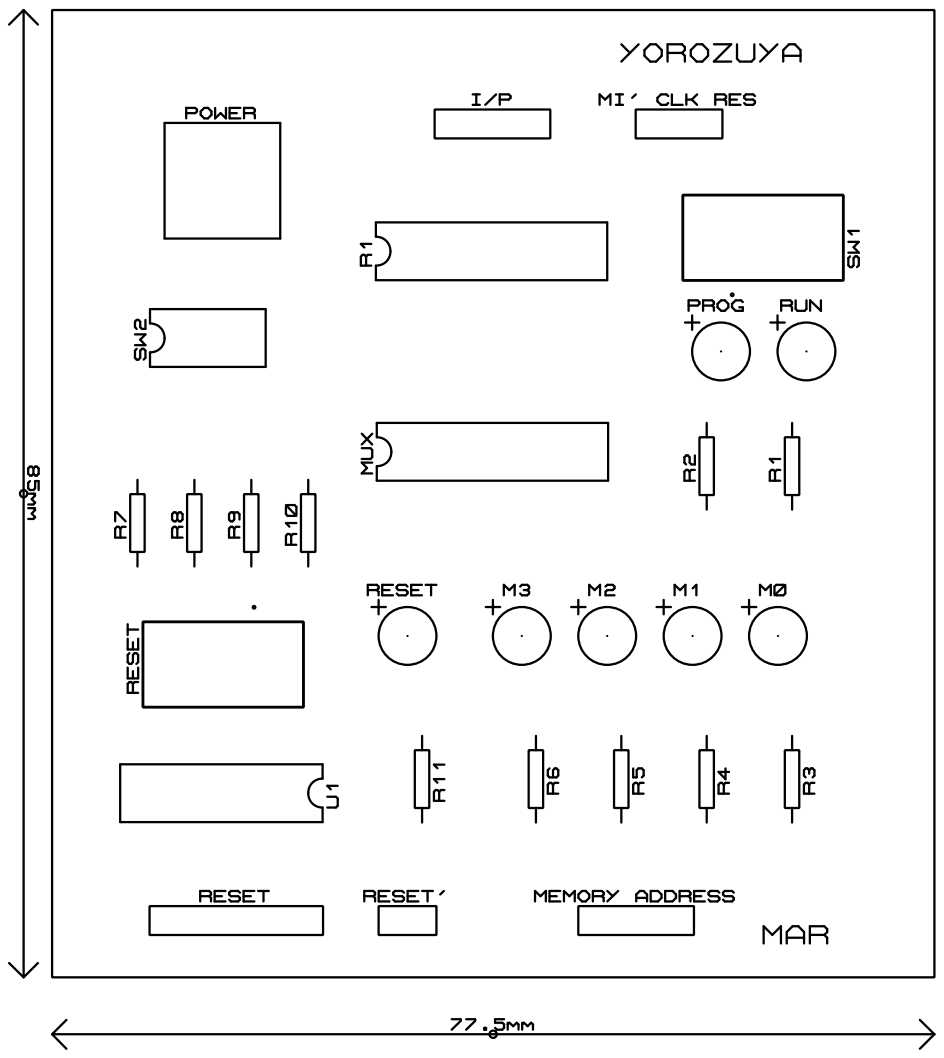
[picture p63: page 1]
