NazmulRemon/SAP-1/Counter/bottomcopper_mirror.PDF

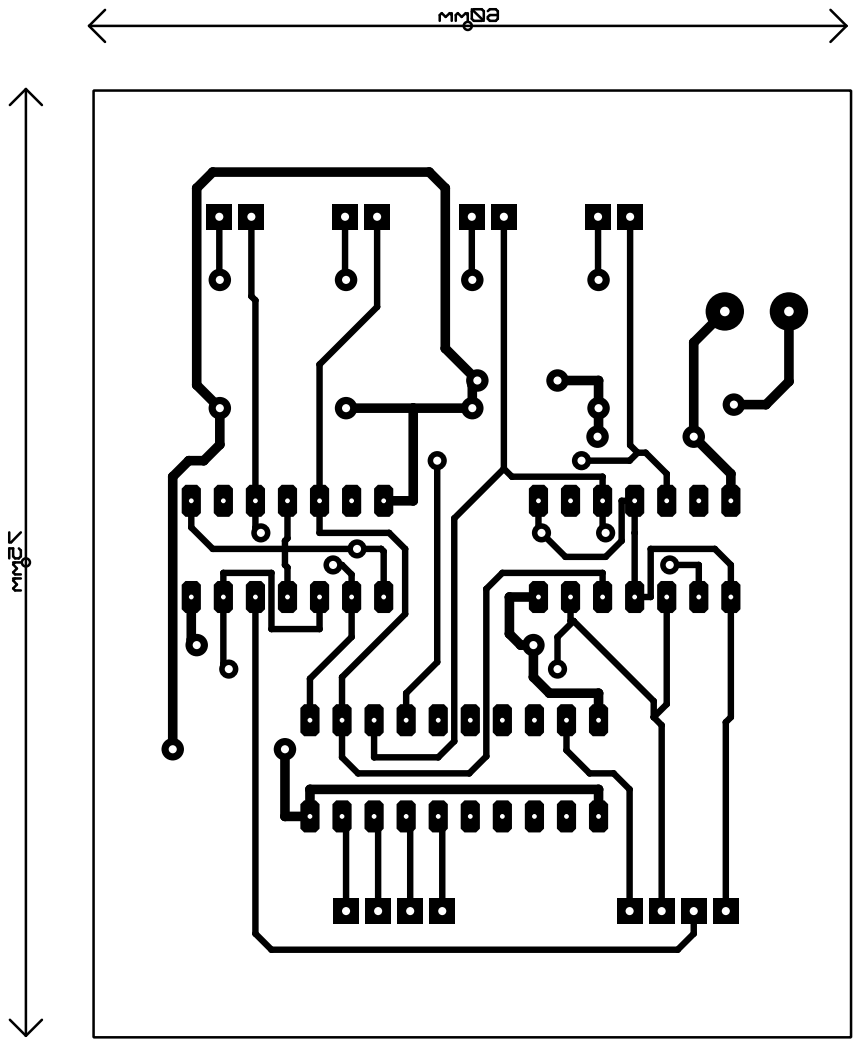
[picture p64: page 1]
