NazmulRemon/SAP-1/Counter/topcopper.PDF

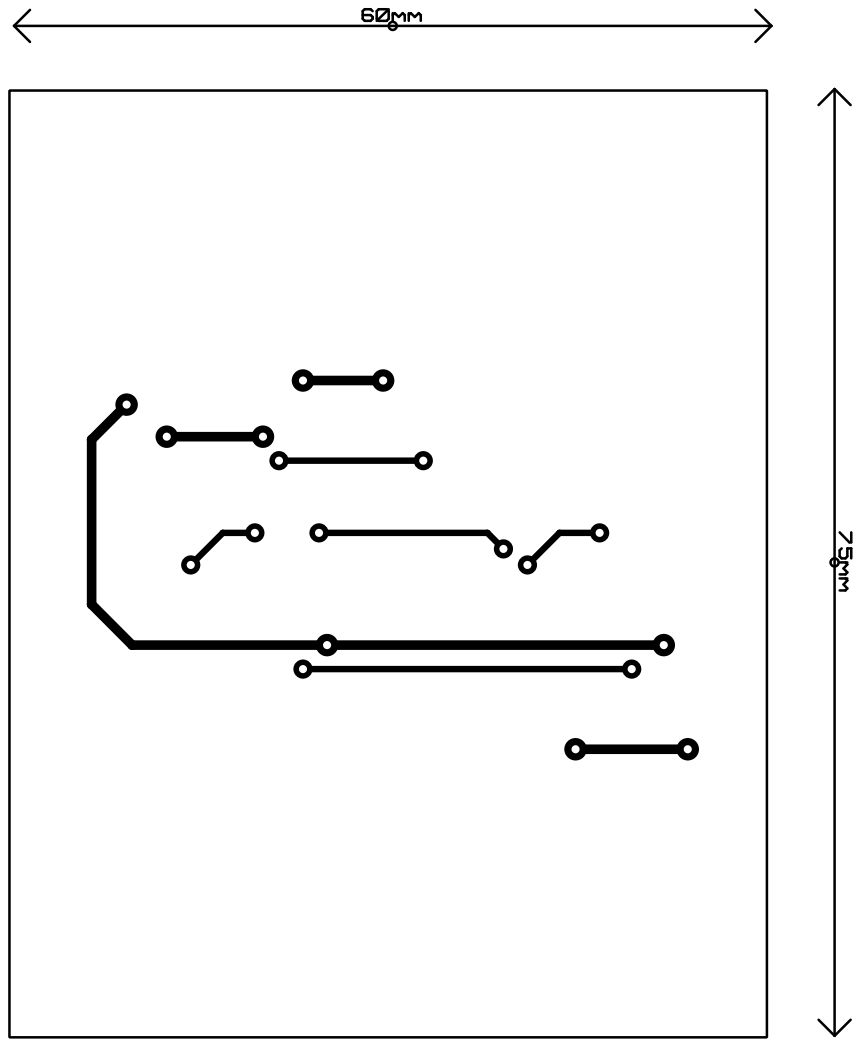
[picture p65: page 1]
