NazmulRemon/SAP-1/Counter/topsilk.PDF

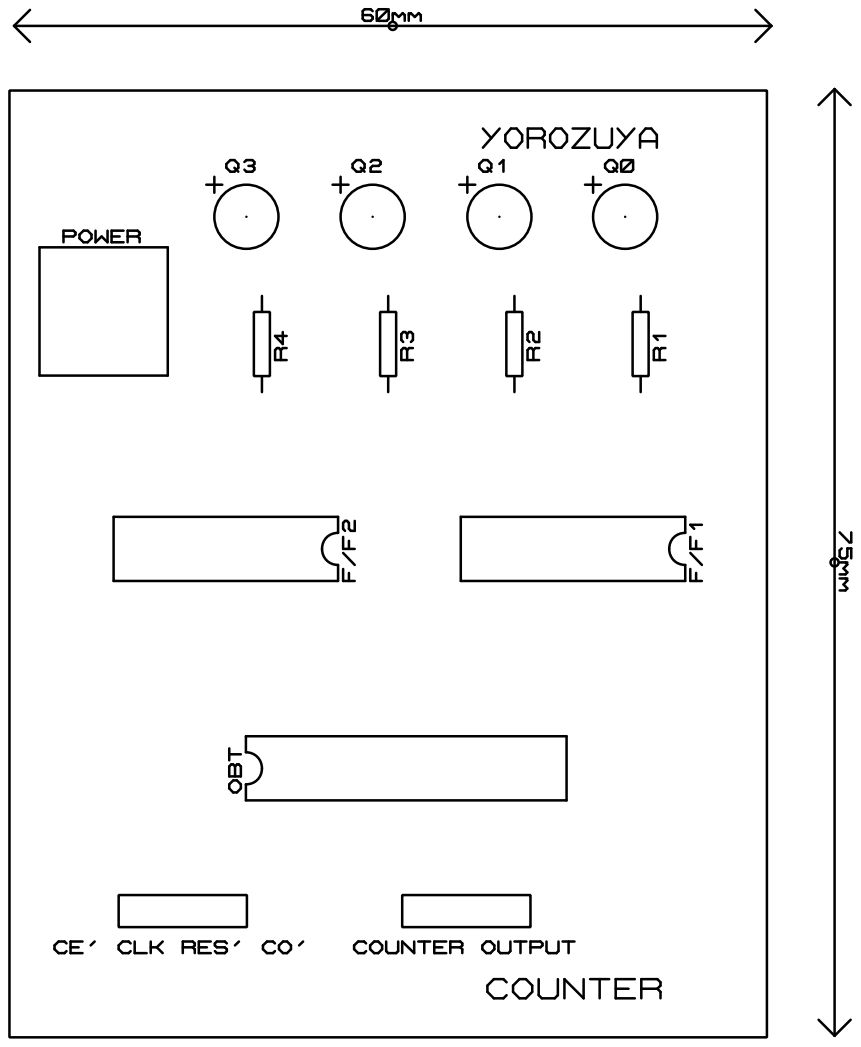
[picture p66: page 1]
