NazmulRemon/SAP-1/ALU/BOTTOMCOPPER_MIRROR.PDF

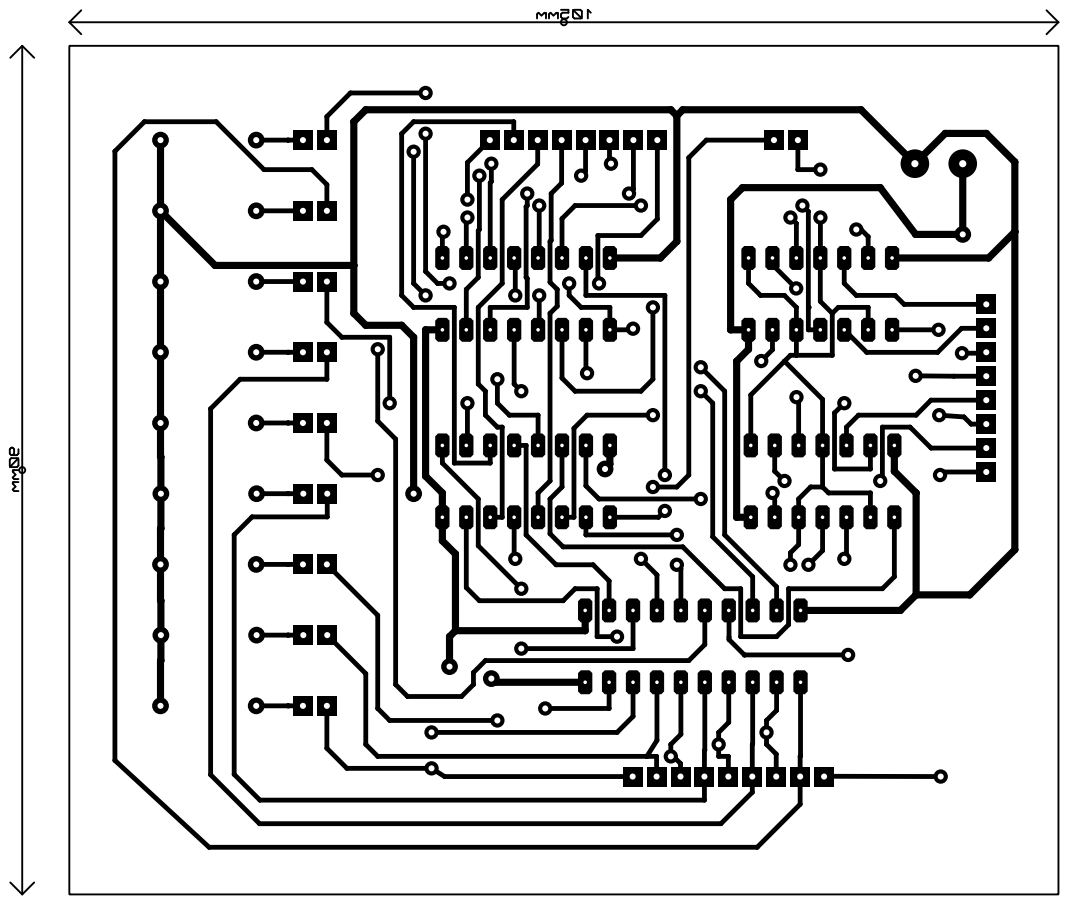
[picture p67: page 1]
