NazmulRemon/SAP-1/ALU/TOPCOPPER.PDF

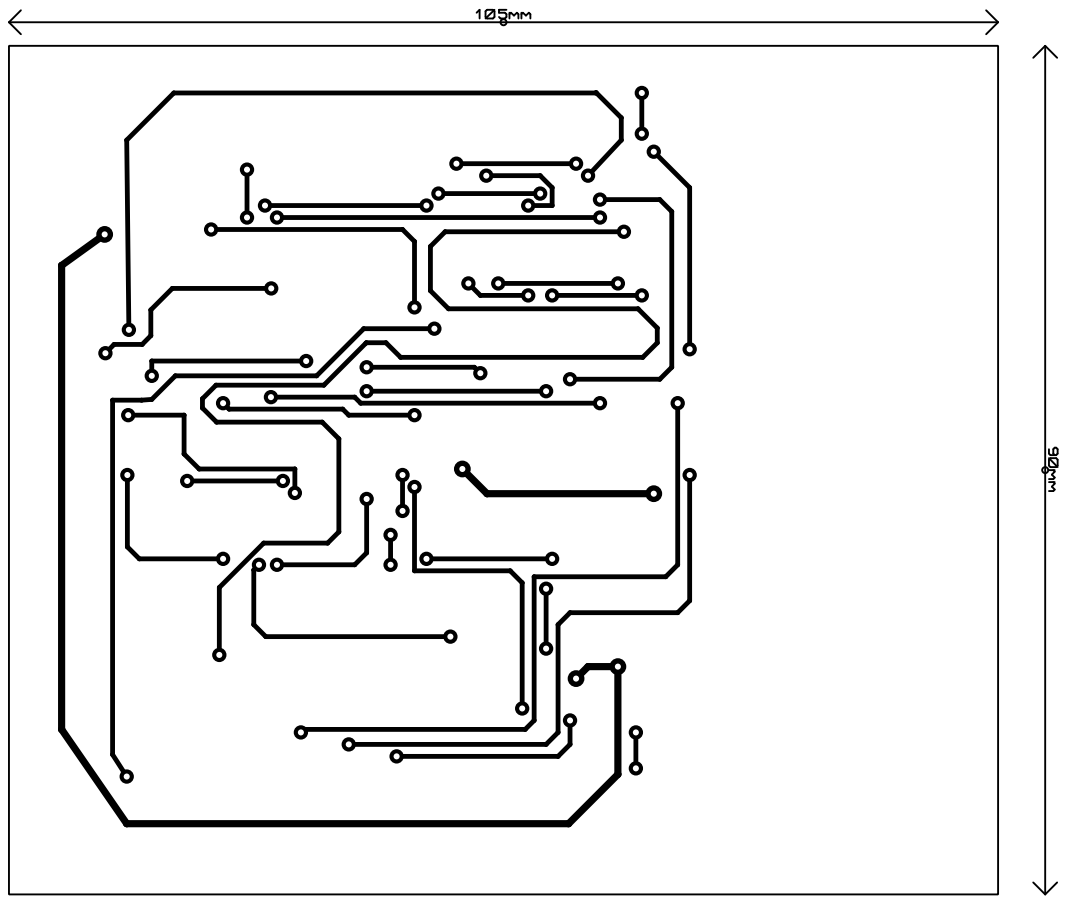
[picture p68: page 1]
