NazmulRemon/SAP-1/ALU/TOPSILK.PDF

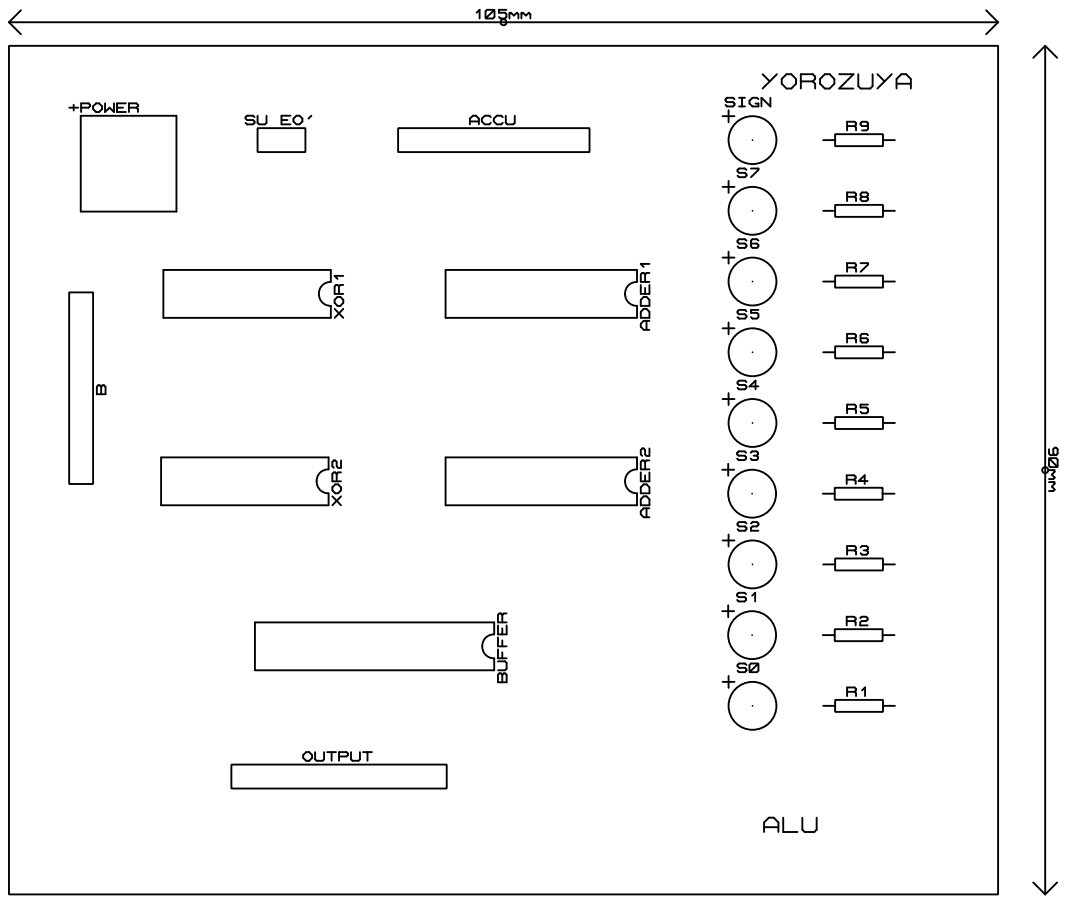
[picture p69: page 1]
