NazmulRemon/SAP-1/(list of files, drawings)

Other design files:
Accumulator/ACCUMULATOR_updated.pdsprj
ALU/ALU_PCB.pdsprj
B register/B REGISTER PCB.pdsprj
BUS/bus.pdsprj
Clock/pcb_clock.pdsprj
Control Sequencer/CONTROLLER_SEQUENCER.pdsprj
Control Sequencer/pcb.pdsprj
Counter/pcb_counter.pdsprj
Instruction Register/INSTRUCTOR RESISTOR-pcb.pdsprj
IP and MAR/IP and MAR_pcb.pdsprj
Output Register/pcb design of output register sap 1.pdsprj
Power module/powermodule.pdsprj
RAM/RAM.pdsprj
SAP_combined/SAP1.pdsprj
